seedrick/Open-ReVolt-AC/Hardware/AC Control BoM.xlsx

Sheet: ACControlAndDriverBoardBOM8-13-
Bill of Materials
Ref Name | Component | Value | Package | MPN
TEMP | 2 pin interface | 2pin vert lock | USER | 171856-0002 (http://www.mouser.com/ProductDetail/Molex/171856-0002/) | 171856-0002|6
 | 2 pin housing |  |  | 22-01-3027 (http://www.mouser.com/ProductDetail/Molex/22-01-3027/) | 22-01-3027|6
J4 | 2 pin interface | No Connector | bigHoles0-1LS
CONTACTOR | 2 pin interface | No Connector | bigHoles0-1LS
PRECHARGE | 2 pin interface | No Connector | bigHoles0-1LS
J2 | 2 pin interface | No Connector | bigHoles0-1LS
J3 | 2 pin interface | No Connector | bigHoles0-1LS
U20 | 7805Replacement |  | USER | OKI-78SR-5/1.5-W36-C (http://www.mouser.com/Search/ProductDetail.aspx) | OKI-78SR-5/1.5-W36-C (http://www.mouser.com/Search/ProductDetail.aspx)
U7 | ATTiny25 |  | DIP8 | ATTINY25-20PU (http://www.mouser.com/Search/ProductDetail.aspx) | ATTINY25-20PU (http://www.mouser.com/Search/ProductDetail.aspx)
D32 | BAT85,133 |  | USER | BAT85S-TAP (http://www.mouser.com/Search/ProductDetail.aspx)
D33 | BAT85,133 |  | USER | BAT85S-TAP (http://www.mouser.com/Search/ProductDetail.aspx)
C132 | Capacitor0.2-MLCC | 0.1uF | Cap01LS | K104K15X7RF53L2 (http://www.mouser.com/Search/ProductDetail.aspx)
C136 | Capacitor0.2-MLCC | 0.1uF | Cap01LS | K104K15X7RF53L2 (http://www.mouser.com/Search/ProductDetail.aspx)
C133 | Capacitor0.2-MLCC | 0.1uF | Cap01LS | K104K15X7RF53L2 (http://www.mouser.com/Search/ProductDetail.aspx)
C137 | Capacitor0.2-MLCC | 0.1uF | Cap01LS | K104K15X7RF53L2 (http://www.mouser.com/Search/ProductDetail.aspx)
C129 | Capacitor0.2-MLCC | 0.1uF | Cap01LS | K104K15X7RF53L2 (http://www.mouser.com/Search/ProductDetail.aspx)
C59 | Capacitor0.2-MLCC | 0.1uF | Cap01LS | K104K15X7RF53L2 (http://www.mouser.com/Search/ProductDetail.aspx)
C61 | Capacitor0.2-MLCC | 0.1uF | Cap01LS | K104K15X7RF53L2 (http://www.mouser.com/Search/ProductDetail.aspx)
C68 | Capacitor0.2-MLCC | 0.1uF | Cap01LS | K104K15X7RF53L2 (http://www.mouser.com/Search/ProductDetail.aspx)
C119 | Capacitor0.2-MLCC | 0.1uF | Cap01LS | K104K15X7RF53L2 (http://www.mouser.com/Search/ProductDetail.aspx)
C40 | Capacitor0.2-MLCC | 0.1uF | Cap01LS | K104K15X7RF53L2 (http://www.mouser.com/Search/ProductDetail.aspx)
C120 | Capacitor0.2-MLCC | 0.1uF | Cap01LS | K104K15X7RF53L2 (http://www.mouser.com/Search/ProductDetail.aspx)
C42 | Capacitor0.2-MLCC | 0.1uF | Cap01LS | K104K15X7RF53L2 (http://www.mouser.com/Search/ProductDetail.aspx)
C122 | Capacitor0.2-MLCC | 0.1uF | Cap01LS | K104K15X7RF53L2 (http://www.mouser.com/Search/ProductDetail.aspx)
C44 | Capacitor0.2-MLCC | 0.1uF | Cap01LS | K104K15X7RF53L2 (http://www.mouser.com/Search/ProductDetail.aspx)
C71 | Capacitor0.2-MLCC | 0.1uF | Cap01LS | K104K15X7RF53L2 (http://www.mouser.com/Search/ProductDetail.aspx)
C78 | Capacitor0.2-MLCC | 0.1uF | Cap01LS | K104K15X7RF53L2 (http://www.mouser.com/Search/ProductDetail.aspx)
C60 | Capacitor0.2-MLCC | 0.1uF | Cap01LS | K104K15X7RF53L2 (http://www.mouser.com/Search/ProductDetail.aspx)
C128 | Capacitor0.2-MLCC | 0.1uF | Cap01LS | K104K15X7RF53L2 (http://www.mouser.com/Search/ProductDetail.aspx)
C65 | Capacitor0.2-MLCC | 0.01uF | Cap01LS | K103K15X7RF5TL2 (http://www.mouser.com/Search/ProductDetail.aspx)
C64 | Capacitor0.2-MLCC | 0.01uF | Cap01LS | K103K15X7RF5TL2 (http://www.mouser.com/Search/ProductDetail.aspx)
C70 | Capacitor0.2-MLCC | 0.01uF | Cap01LS | K103K15X7RF5TL2 (http://www.mouser.com/Search/ProductDetail.aspx)
C69 | Capacitor0.2-MLCC | 0.01uF | Cap01LS | K103K15X7RF5TL2 (http://www.mouser.com/Search/ProductDetail.aspx)
C19 | Capacitor0.2-MLCC | 6800pF | Cap01LS | FK18X7R1H682K (http://www.mouser.com/Search/ProductDetail.aspx)
C99 | Capacitor0.2-MLCC | 6800pF | Cap01LS | FK18X7R1H682K (http://www.mouser.com/Search/ProductDetail.aspx)
C22 | Capacitor0.2-MLCC | 6800pF | Cap01LS | FK18X7R1H682K (http://www.mouser.com/Search/ProductDetail.aspx)
C102 | Capacitor0.2-MLCC | 6800pF | Cap01LS | FK18X7R1H682K (http://www.mouser.com/Search/ProductDetail.aspx)
C25 | Capacitor0.2-MLCC | 6800pF | Cap01LS | FK18X7R1H682K (http://www.mouser.com/Search/ProductDetail.aspx)
C105 | Capacitor0.2-MLCC | 6800pF | Cap01LS | FK18X7R1H682K (http://www.mouser.com/Search/ProductDetail.aspx)
C62 | Capacitor0.2-MLCC | 4.7uF | Cap01LS | FK14X7R1E475K (http://www.mouser.com/Search/ProductDetail.aspx)
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
U22 | GateDriveOptoWithReset | FOD8316 | SOIC16 | FOD8316 (http://www.mouser.com/ProductDetail/Fairchild-Semiconductor/FOD8316/?qs=sGAEpiMZZMvh4wEfREVcMVUAyWQG%252brzT)
U2 | GateDriveOptoWithReset | FOD8316 | SOIC16 | FOD8316 (http://www.mouser.com/ProductDetail/Fairchild-Semiconductor/FOD8316/?qs=sGAEpiMZZMvh4wEfREVcMVUAyWQG%252brzT)
U23 | GateDriveOptoWithReset | FOD8316 | SOIC16 | FOD8316 (http://www.mouser.com/ProductDetail/Fairchild-Semiconductor/FOD8316/?qs=sGAEpiMZZMvh4wEfREVcMVUAyWQG%252brzT)
U3 | GateDriveOptoWithReset | FOD8316 | SOIC16 | FOD8316 (http://www.mouser.com/ProductDetail/Fairchild-Semiconductor/FOD8316/?qs=sGAEpiMZZMvh4wEfREVcMVUAyWQG%252brzT)
U16 | HIN202CP |  | DIL | HIN202CPZ (http://www.mouser.com/Search/ProductDetail.aspx?R=HIN202CPZvirtualkey57760000virtualkey968-HIN202CPZ)
ISP | ISP-Interface |  | USER | 929834-02-06-RK (http://www.mouser.com/Search/ProductDetail.aspx)
U4 | IXDN604MosfetDriver |  | DIP8 | IXDN604PI (http://www.mouser.com/Search/ProductDetail.aspx?R=IXDN604PIvirtualkey56550000virtualkey849-IXDN604PI)
U24 | IXDN604MosfetDriver |  | DIP8 | IXDN604PI (http://www.mouser.com/Search/ProductDetail.aspx?R=IXDN604PIvirtualkey56550000virtualkey849-IXDN604PI)
U5 | IXDN604MosfetDriver |  | DIP8 | IXDN604PI (http://www.mouser.com/Search/ProductDetail.aspx?R=IXDN604PIvirtualkey56550000virtualkey849-IXDN604PI)
U25 | IXDN604MosfetDriver |  | DIP8 | IXDN604PI (http://www.mouser.com/Search/ProductDetail.aspx?R=IXDN604PIvirtualkey56550000virtualkey849-IXDN604PI)
U6 | IXDN604MosfetDriver |  | DIP8 | IXDN604PI (http://www.mouser.com/Search/ProductDetail.aspx?R=IXDN604PIvirtualkey56550000virtualkey849-IXDN604PI)
U26 | IXDN604MosfetDriver |  | DIP8 | IXDN604PI (http://www.mouser.com/Search/ProductDetail.aspx?R=IXDN604PIvirtualkey56550000virtualkey849-IXDN604PI)
CURRENT1 | LEMInterface | 3pin Vert Lock | writingFlipped | 22-23-2031 (http://www.mouser.com/Search/ProductDetail.aspx)
CURRENT3 | LEMInterface | 3pin Vert Lock | writingFlipped | 22-23-2031 (http://www.mouser.com/Search/ProductDetail.aspx)
CURRENT2 | LEMInterface | 3pin Vert Lock | writingFlipped | 22-23-2031 (http://www.mouser.com/Search/ProductDetail.aspx)
J1 | Hall Effect | 3pin Vert Lock |  | 22-23-2031 (http://www.mouser.com/Search/ProductDetail.aspx)
 | SerialInterface | 3pin Vert Lock |  | 22-23-2031 (http://www.mouser.com/Search/ProductDetail.aspx)
 |  | 3 pin Housing x 5 |  | 22-01-3037 (http://www.mouser.com/Search/ProductDetail.aspx)
 |  | 4 pin Housing x 3 |  | 22-01-3047 (http://www.mouser.com/Search/ProductDetail.aspx)
 |  | Crimp Pins x 34 |  | 08-50-0114 (http://www.mouser.com/Search/ProductDetail.aspx)
TRANS4 | Line Filter |  | 13x10mmHoles | PLA10AN3021R3R2B (http://www.mouser.com/Search/ProductDetail.aspx)
TRANS1 | Line Filter |  | 13x10mmHoles | PLA10AN3021R3R2B (http://www.mouser.com/Search/ProductDetail.aspx)
TRANS5 | Line Filter |  | 13x10mmHoles | PLA10AN3021R3R2B (http://www.mouser.com/Search/ProductDetail.aspx)
TRANS2 | Line Filter |  | 13x10mmHoles | PLA10AN3021R3R2B (http://www.mouser.com/Search/ProductDetail.aspx)
TRANS6 | Line Filter |  | 13x10mmHoles | PLA10AN3021R3R2B (http://www.mouser.com/Search/ProductDetail.aspx)
TRANS3 | Line Filter |  | 13x10mmHoles | PLA10AN3021R3R2B (http://www.mouser.com/Search/ProductDetail.aspx)
U8 | LM393 |  | DIP-8-Oval | LM293P (http://www.mouser.com/ProductDetail/Texas-Instruments/LM293P/)
U15 | LM393 |  | DIP-8-Oval | LM293P (http://www.mouser.com/ProductDetail/Texas-Instruments/LM293P/)
U9 | LM393 |  | DIP-8-Oval | LM293P (http://www.mouser.com/ProductDetail/Texas-Instruments/LM293P/)
U19 | LM393 |  | DIP-8-Oval | LM293P (http://www.mouser.com/ProductDetail/Texas-Instruments/LM293P/)
U12 | LM4040DIZ-2.5 | LM4040C25ILPR | TO92 | LM4040C25ILPR (http://www.mouser.com/Search/ProductDetail.aspx)
U18 | MC74HC00AD |  | dip14 | SN74HC00N (http://www.mouser.com/Search/ProductDetail.aspx?R=SN74HC00Nvirtualkey59500000virtualkey595-SN74HC00N)
Q7 | MOSFET n-ch |  | TO-92 | BS270 (http://www.mouser.com/Search/ProductDetail.aspx?R=BS270virtualkey51210000virtualkey512-BS270)
Q8 | MOSFET n-ch |  | TO-92 | BS270 (http://www.mouser.com/Search/ProductDetail.aspx?R=BS270virtualkey51210000virtualkey512-BS270)
Q9 | NPNTrans_D44VH10 |  | DPAK | 511-MJD44H11 (http://www.mouser.com/ProductDetail/STMicroelectronics/MJD44H11T4/)
Q2 | NPNTrans_D44VH10 |  | DPAK | 511-MJD44H11 (http://www.mouser.com/ProductDetail/STMicroelectronics/MJD44H11T4/)
Q11 | NPNTrans_D44VH10 |  | DPAK | 511-MJD44H11 (http://www.mouser.com/ProductDetail/STMicroelectronics/MJD44H11T4/)
Q13 | NPNTrans_D44VH10 |  | DPAK | 511-MJD44H11 (http://www.mouser.com/ProductDetail/STMicroelectronics/MJD44H11T4/)
Q6 | NPNTrans_D44VH10 |  | DPAK | 511-MJD44H11 (http://www.mouser.com/ProductDetail/STMicroelectronics/MJD44H11T4/)
Q4 | NPNTrans_D44VH10 |  | DPAK | 511-MJD44H11 (http://www.mouser.com/ProductDetail/STMicroelectronics/MJD44H11T4/)
D31 | P6KE20A-T | Bidirectional | USER | P6KE18CA (http://www.mouser.com/Search/ProductDetail.aspx?R=P6KE18CAvirtualkey51120000virtualkey511-P6KE18CA)
D30 | P6KE20A-T | Bidirectional | USER | P6KE18CA (http://www.mouser.com/Search/ProductDetail.aspx?R=P6KE18CAvirtualkey51120000virtualkey511-P6KE18CA)
Q1 | PNPTRANS_D45VH10 |  | DPAK | 863-MJD45H11T4G (http://www.mouser.com/Search/ProductDetail.aspx)
Q10 | PNPTRANS_D45VH10 |  | DPAK | 863-MJD45H11T4G (http://www.mouser.com/Search/ProductDetail.aspx)
Q3 | PNPTRANS_D45VH10 |  | DPAK | 863-MJD45H11T4G (http://www.mouser.com/Search/ProductDetail.aspx)
Q12 | PNPTRANS_D45VH10 |  | DPAK | 863-MJD45H11T4G (http://www.mouser.com/Search/ProductDetail.aspx)
Q5 | PNPTRANS_D45VH10 |  | DPAK | 863-MJD45H11T4G (http://www.mouser.com/Search/ProductDetail.aspx)
Q14 | PNPTRANS_D45VH10 |  | DPAK | 863-MJD45H11T4G (http://www.mouser.com/Search/ProductDetail.aspx)
QEI | QEI | 5p Vert 0.1ls | USER | 171856-1005 (http://www.mouser.com/Search/ProductDetail.aspx)
RELAY1 | Relay SPST 1FormA |  | User | ALQ305 (http://www.mouser.com/Search/ProductDetail.aspx?R=ALQ305virtualkey66710000virtualkey769-ALQ305)
RELAY2 | Relay SPST 1FormA |  | User | ALQ305 (http://www.mouser.com/Search/ProductDetail.aspx?R=ALQ305virtualkey66710000virtualkey769-ALQ305)
R22 | Resistor-0.25watt | 1k | R0_4 | MF1/4DCT52A1001F (http://www.mouser.com/Search/ProductDetail.aspx)
R39 | Resistor-0.25watt | 1k | R0_4 | MF1/4DCT52A1001F (http://www.mouser.com/Search/ProductDetail.aspx)
R50 | Resistor-0.25watt | 1k | R0_4 | MF1/4DCT52A1001F (http://www.mouser.com/Search/ProductDetail.aspx)
R52 | Resistor-0.25watt | 1k | R0_4 | MF1/4DCT52A1001F (http://www.mouser.com/Search/ProductDetail.aspx)
R54 | Resistor-0.25watt | 1k | R0_4 | MF1/4DCT52A1001F (http://www.mouser.com/Search/ProductDetail.aspx)
R55 | Resistor-0.25watt | 1k | R0_4 | MF1/4DCT52A1001F (http://www.mouser.com/Search/ProductDetail.aspx)
R56 | Resistor-0.25watt | 1k | R0_4 | MF1/4DCT52A1001F (http://www.mouser.com/Search/ProductDetail.aspx)
R60 | Resistor-0.25watt | 1k | RVertical | MF1/4DCT52A1001F (http://www.mouser.com/Search/ProductDetail.aspx)
R63 | Resistor-0.25watt | 1k | R0_4 | MF1/4DCT52A1001F (http://www.mouser.com/Search/ProductDetail.aspx)
R64 | Resistor-0.25watt | 1k | R0_4 | MF1/4DCT52A1001F (http://www.mouser.com/Search/ProductDetail.aspx)
R31 | Resistor-0.25watt | 1.5k | R0_4 | CCF601K50FKE36 (http://www.mouser.com/ProductDetail/Vishay-Dale/CCF601K50FKE36/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)
R25 | Resistor-0.25watt | 2k | R0_4 | MF1/4DCT52A2001F (http://www.mouser.com/Search/ProductDetail.aspx)
R26 | Resistor-0.25watt | 2k | R0_4 | MF1/4DCT52A2001F (http://www.mouser.com/Search/ProductDetail.aspx)
R48 | Resistor-0.25watt | 2k | R0_4 | MF1/4DCT52A2001F (http://www.mouser.com/Search/ProductDetail.aspx)
R49 | Resistor-0.25watt | 2k | R0_4 | MF1/4DCT52A2001F (http://www.mouser.com/Search/ProductDetail.aspx)
R27 | Resistor-0.25watt | 2k | R0_4 | MF1/4DCT52A2001F (http://www.mouser.com/Search/ProductDetail.aspx)
R29 | Resistor-0.25watt | 2k | R0_4 | MF1/4DCT52A2001F (http://www.mouser.com/Search/ProductDetail.aspx)
R58 | Resistor-0.25watt | 2k | R0_4 | MF1/4DCT52A2001F (http://www.mouser.com/Search/ProductDetail.aspx)
R59 | Resistor-0.25watt | 2k | R0_4 | MF1/4DCT52A2001F (http://www.mouser.com/Search/ProductDetail.aspx)
R51 | Resistor-0.25watt | 100k | R0_4 | MFR-25FRF52-100K (http://www.mouser.com/Search/ProductDetail.aspx)
R33 | Resistor-0.25watt | 1k | R0_4 | MF1/4DCT52A1001F (http://www.mouser.com/Search/ProductDetail.aspx)
R46 | Resistor-0.25watt | 2.8k 0.1% | R0_4 | CMF1/42801FLFTR (http://www.mouser.com/Search/ProductDetail.aspx)
R19 | Resistor-0.25watt | 2.7Ohm | r0-500 | OF27GJE (http://www.mouser.com/Search/ProductDetail.aspx?R=OF27GJEvirtualkey58810000virtualkey588-OF27GJE)
R84 | Resistor-0.25watt | 2.7Ohm | r0-500 | OF27GJE (http://www.mouser.com/Search/ProductDetail.aspx?R=OF27GJEvirtualkey58810000virtualkey588-OF27GJE)
R20 | Resistor-0.25watt | 2.7Ohm | r0-500 | OF27GJE (http://www.mouser.com/Search/ProductDetail.aspx?R=OF27GJEvirtualkey58810000virtualkey588-OF27GJE)
R85 | Resistor-0.25watt | 2.7Ohm | r0-500 | OF27GJE (http://www.mouser.com/Search/ProductDetail.aspx?R=OF27GJEvirtualkey58810000virtualkey588-OF27GJE)
R21 | Resistor-0.25watt | 2.7Ohm | r0-500 | OF27GJE (http://www.mouser.com/Search/ProductDetail.aspx?R=OF27GJEvirtualkey58810000virtualkey588-OF27GJE)
R86 | Resistor-0.25watt | 2.7Ohm | r0-500 | OF27GJE (http://www.mouser.com/Search/ProductDetail.aspx?R=OF27GJEvirtualkey58810000virtualkey588-OF27GJE)
R24 | Resistor-0.25watt | 3k | R0_4 | MF1/4DC3001F (http://www.mouser.com/ProductDetail/KOA-Speer/MF1-4DC3001F/)
R62 | Resistor-0.25watt | 3k | R0_4 | MF1/4DC3001F
R65 | Resistor-0.25watt | 3k | R0_4 | MF1/4DC3001F
R32 | Resistor-0.25watt | 3k | R0_4 | MF1/4DC3001F
R75 | Resistor-0.25watt | 3k | 1210 | CRCW12103K00JNEA (http://www.mouser.com/Search/ProductDetail.aspx)
R10 | Resistor-0.25watt | 3k | 1210 | CRCW12103K00JNEA (http://www.mouser.com/Search/ProductDetail.aspx)
R76 | Resistor-0.25watt | 3k | 1210 | CRCW12103K00JNEA (http://www.mouser.com/Search/ProductDetail.aspx)
R11 | Resistor-0.25watt | 3k | 1210 | CRCW12103K00JNEA (http://www.mouser.com/Search/ProductDetail.aspx)
R77 | Resistor-0.25watt | 3k | 1210 | CRCW12103K00JNEA (http://www.mouser.com/Search/ProductDetail.aspx)
R12 | Resistor-0.25watt | 3k | 1210 | CRCW12103K00JNEA (http://www.mouser.com/Search/ProductDetail.aspx)
R2 | Resistor-0.25watt | 3.3Ohm 1w | R0800 | OX33GKE (http://www.mouser.com/Search/ProductDetail.aspx?R=OX33GKEvirtualkey58810000virtualkey588-OX-3.3-E)
R66 | Resistor-0.25watt | 3.3Ohm 1w | R0800 | OX33GKE (http://www.mouser.com/Search/ProductDetail.aspx?R=OX33GKEvirtualkey58810000virtualkey588-OX-3.3-E)
R67 | Resistor-0.25watt | 3.3Ohm 1w | R0800 | OX33GKE (http://www.mouser.com/Search/ProductDetail.aspx?R=OX33GKEvirtualkey58810000virtualkey588-OX-3.3-E)
R3 | Resistor-0.25watt | 3.3Ohm 1w | R0800 | OX33GKE (http://www.mouser.com/Search/ProductDetail.aspx?R=OX33GKEvirtualkey58810000virtualkey588-OX-3.3-E)
R4 | Resistor-0.25watt | 3.3Ohm 1w | R0800 | OX33GKE (http://www.mouser.com/Search/ProductDetail.aspx?R=OX33GKEvirtualkey58810000virtualkey588-OX-3.3-E)
R68 | Resistor-0.25watt | 3.3Ohm 1w | R0800 | OX33GKE (http://www.mouser.com/Search/ProductDetail.aspx?R=OX33GKEvirtualkey58810000virtualkey588-OX-3.3-E)
R69 | Resistor-0.25watt | 3.3Ohm 1w | R0800 | OX33GKE (http://www.mouser.com/Search/ProductDetail.aspx?R=OX33GKEvirtualkey58810000virtualkey588-OX-3.3-E)
R5 | Resistor-0.25watt | 3.3Ohm 1w | R0800 | OX33GKE (http://www.mouser.com/Search/ProductDetail.aspx?R=OX33GKEvirtualkey58810000virtualkey588-OX-3.3-E)
R6 | Resistor-0.25watt | 3.3Ohm 1w | R0800 | OX33GKE (http://www.mouser.com/Search/ProductDetail.aspx?R=OX33GKEvirtualkey58810000virtualkey588-OX-3.3-E)
R70 | Resistor-0.25watt | 3.3Ohm 1w | R0800 | OX33GKE (http://www.mouser.com/Search/ProductDetail.aspx?R=OX33GKEvirtualkey58810000virtualkey588-OX-3.3-E)
R71 | Resistor-0.25watt | 3.3Ohm 1w | R0800 | OX33GKE (http://www.mouser.com/Search/ProductDetail.aspx?R=OX33GKEvirtualkey58810000virtualkey588-OX-3.3-E)
R7 | Resistor-0.25watt | 3.3Ohm 1w | R0800 | OX33GKE (http://www.mouser.com/Search/ProductDetail.aspx?R=OX33GKEvirtualkey58810000virtualkey588-OX-3.3-E)
R43 | Resistor-0.25watt | 3.92k 0.1% | R0_4 | MF1/4DC3921F (http://www.mouser.com/Search/ProductDetail.aspx)
R40 | Resistor-0.25watt | 4.7k | R0_4 | MF1/4DCT52R4701F (http://www.mouser.com/Search/ProductDetail.aspx)
R44 | Resistor-0.25watt | 4.7k 0.1% | R0_4 | MF1/4DCT52R4701F (http://www.mouser.com/Search/ProductDetail.aspx)
R61 | Resistor-0.25watt | 4.7k | RVertical | MF1/4DCT52R4701F (http://www.mouser.com/Search/ProductDetail.aspx)
R13 | Resistor-0.25watt | 15Ohm 0.5w | 45 | 273-15-RC (http://www.mouser.com/Search/ProductDetail.aspx?R=273-15-RCvirtualkey21980000virtualkey273-15-RC)
R78 | Resistor-0.25watt | 15Ohm 0.5w | 45 | 273-15-RC (http://www.mouser.com/Search/ProductDetail.aspx?R=273-15-RCvirtualkey21980000virtualkey273-15-RC)
R14 | Resistor-0.25watt | 15Ohm 0.5w | 45 | 273-15-RC (http://www.mouser.com/Search/ProductDetail.aspx?R=273-15-RCvirtualkey21980000virtualkey273-15-RC)
R79 | Resistor-0.25watt | 15Ohm 0.5w | 45 | 273-15-RC (http://www.mouser.com/Search/ProductDetail.aspx?R=273-15-RCvirtualkey21980000virtualkey273-15-RC)
R15 | Resistor-0.25watt | 15Ohm 0.5w | 45 | 273-15-RC (http://www.mouser.com/Search/ProductDetail.aspx?R=273-15-RCvirtualkey21980000virtualkey273-15-RC)
R80 | Resistor-0.25watt | 15Ohm 0.5w | 45 | 273-15-RC (http://www.mouser.com/Search/ProductDetail.aspx?R=273-15-RCvirtualkey21980000virtualkey273-15-RC)
R45 | Resistor-0.25watt | 10k | R0_4 | MF1/4DC1002F (http://www.mouser.com/Search/ProductDetail.aspx)
R23 | Resistor-0.25watt | 10k | R0_4 | MF1/4DC1002F (http://www.mouser.com/Search/ProductDetail.aspx)
R28 | Resistor-0.25watt | 10k | R0_4 | MF1/4DC1002F (http://www.mouser.com/Search/ProductDetail.aspx)
R30 | Resistor-0.25watt | 10k | R0_4 | MF1/4DC1002F (http://www.mouser.com/Search/ProductDetail.aspx)
R42 | Resistor-0.25watt | 10k | RVertical | MF1/4DC1002F (http://www.mouser.com/Search/ProductDetail.aspx)
R36 | Resistor-0.25watt | 10k | R0_4 | MF1/4DC1002F (http://www.mouser.com/Search/ProductDetail.aspx)
R37 | Resistor-0.25watt | 10k | R0_4 | MF1/4DC1002F (http://www.mouser.com/Search/ProductDetail.aspx)
R35 | Resistor-0.25watt | 10k | R0_4 | MF1/4DC1002F (http://www.mouser.com/Search/ProductDetail.aspx)
R38 | Resistor-0.25watt | 10k | R0_4 | MF1/4DC1002F (http://www.mouser.com/Search/ProductDetail.aspx)
R41 | Resistor-0.25watt | 10k | R0_4 | MF1/4DC1002F (http://www.mouser.com/Search/ProductDetail.aspx)
R34 | Resistor-0.25watt | 10k | R0_4 | MF1/4DC1002F (http://www.mouser.com/Search/ProductDetail.aspx)
R47 | Resistor-0.25watt | 22k 0.1% | R0_4 | MF1/4DC2202F (http://www.mouser.com/Search/ProductDetail.aspx)
R16 | Resistor-0.25watt | 47k | 1210 | CRCW121047K0JNEA (http://www.mouser.com/Search/ProductDetail.aspx)
R81 | Resistor-0.25watt | 47k | 1210 | CRCW121047K0JNEA (http://www.mouser.com/Search/ProductDetail.aspx)
R17 | Resistor-0.25watt | 47k | 1210 | CRCW121047K0JNEA (http://www.mouser.com/Search/ProductDetail.aspx)
R82 | Resistor-0.25watt | 47k | 1210 | CRCW121047K0JNEA (http://www.mouser.com/Search/ProductDetail.aspx)
R18 | Resistor-0.25watt | 47k | 1210 | CRCW121047K0JNEA (http://www.mouser.com/Search/ProductDetail.aspx)
R83 | Resistor-0.25watt | 47k | 1210 | CRCW121047K0JNEA (http://www.mouser.com/Search/ProductDetail.aspx)
R1 | Resistor-0.25watt | 100 | 1210 | RK73B2ETTE101J (http://www.mouser.com/Search/ProductDetail.aspx)
R73 | Resistor-0.25watt | 100 | 1210 | RK73B2ETTE101J (http://www.mouser.com/Search/ProductDetail.aspx)
R8 | Resistor-0.25watt | 100 | 1210 | RK73B2ETTE101J (http://www.mouser.com/Search/ProductDetail.aspx)
R74 | Resistor-0.25watt | 100 | 1210 | RK73B2ETTE101J (http://www.mouser.com/Search/ProductDetail.aspx)
R9 | Resistor-0.25watt | 100 | 1210 | RK73B2ETTE101J (http://www.mouser.com/Search/ProductDetail.aspx)
R72 | Resistor-0.25watt | 100 | 1210 | RK73B2ETTE101J (http://www.mouser.com/Search/ProductDetail.aspx)
R57 | Resistor-0.25watt | 470 | R0_4 | MF1/4DC4700F (http://www.mouser.com/Search/ProductDetail.aspx)
R53 | Resistor-0.25watt | xxx | R0_4
U11 | SN74HC08 |  | dip14 | SN74HC08N (http://www.mouser.com/Search/ProductDetail.aspx?R=SN74HC08Nvirtualkey59500000virtualkey595-SN74HC08N)
U14 | SN74HC08 |  | dip14 | SN74HC08N (http://www.mouser.com/Search/ProductDetail.aspx?R=SN74HC08Nvirtualkey59500000virtualkey595-SN74HC08N)
U10 | SN74HC21 |  | dip14 | SN74HC21N (http://www.mouser.com/Search/ProductDetail.aspx?R=SN74HC21Nvirtualkey59500000virtualkey595-SN74HC21N)
U17 | SN74HC21 |  | dip14 | SN74HC21N (http://www.mouser.com/Search/ProductDetail.aspx?R=SN74HC21Nvirtualkey59500000virtualkey595-SN74HC21N)
D29 | STTH2R02 | 1n4148 | vertical | 1N4148-B (http://www.mouser.com/Search/ProductDetail.aspx?R=1N4148-Bvirtualkey58300000virtualkey583-1N4148-B)
D28 | STTH2R02 | 1n4148 | vertical | 1N4148-B (http://www.mouser.com/Search/ProductDetail.aspx?R=1N4148-Bvirtualkey58300000virtualkey583-1N4148-B)
D35 | STTH2R02 | 1000V Ultrafast | 0_45Inch | UF4007-E3/54
D7 | STTH2R02 | 1000V Ultrafast | 0_45Inch | UF4007-E3/54
D36 | STTH2R02 | 1000V Ultrafast | 0_45Inch | UF4007-E3/54
D8 | STTH2R02 | 1000V Ultrafast | 0_45Inch | UF4007-E3/54
D37 | STTH2R02 | 1000V Ultrafast | 0_45Inch | UF4007-E3/54
D9 | STTH2R02 | 1000V Ultrafast | 0_45Inch | UF4007-E3/54
D34 | ZenerDiode | 5.1v Zener | Diode_small | BZX55B5V1-TAP
D23 | ZenerDiode | 8.2v 5w | 5wVertical | 1N5344B-TP (http://www.mouser.com/Search/ProductDetail.aspx)
D50 | ZenerDiode | 8.2v 5w | 5wVertical | 1N5344B-TP (http://www.mouser.com/Search/ProductDetail.aspx)
D25 | ZenerDiode | 8.2v 5w | 5wVertical | 1N5344B-TP (http://www.mouser.com/Search/ProductDetail.aspx)
D52 | ZenerDiode | 8.2v 5w | 5wVertical | 1N5344B-TP (http://www.mouser.com/Search/ProductDetail.aspx)
D27 | ZenerDiode | 8.2v 5w | 5wVertical | 1N5344B-TP (http://www.mouser.com/Search/ProductDetail.aspx)
D54 | ZenerDiode | 8.2v 5w | 5wVertical | 1N5344B-TP (http://www.mouser.com/Search/ProductDetail.aspx)
D1 | ZenerDiode | 17v 5w x2 | bidirectVert | 1N5354BG
D2 | ZenerDiode | 17v 5w x2 | bidirectVert | 1N5354BG
D3 | ZenerDiode | 17v 5w x2 | bidirectVert | 1N5354BG
D6 | ZenerDiode | 17v 5w x2 | bidirectVert | 1N5354BG
D5 | ZenerDiode | 17v 5w x2 | bidirectVert | 1N5354BG
D4 | ZenerDiode | 17v 5w x2 | bidirectVert | 1N5354BG
D22 | ZenerDiode | 24v Zener | 5wVertical | 1N5359BG
D51 | ZenerDiode | 24v Zener | 5wVertical | 1N5359BG
D24 | ZenerDiode | 24v Zener | 5wVertical | 1N5359BG
D53 | ZenerDiode | 24v Zener | 5wVertical | 1N5359BG
D26 | ZenerDiode | 24v Zener | 5wVertical | 1N5359BG
D55 | ZenerDiode | 24v Zener | 5wVertical | 1N5359BG
Thermistor |  |  |  | NTCALUG03A103G (http://www.mouser.com/Search/ProductDetail.aspx)
 |  |  |  | Total Cost

Sheet: Sheet1
 |  |  |  |  |  | 0.888
0.00013366533 |  |  |  |  |  | 2.8125
 |  |  |  |  |  |  |  |  |  | 0.125 | 0.03978873577
 |  |  |  |  | 17.53624817 |  |  |  |  |  | 0.1994711402 |  | 0.00000001
 |  |  | 12.4 |  | 0.1140494808 | 0.1140433553 |  |  | 0.04659393939
 |  |  | 0.1612903226 | 6.2
 |  |  | 352 |  | 1.990123457
 |  |  | 0.169
 | 2.7 | 0.1093117409 | 22.87037037 |  |  |  |  | 274.1633199 |  |  |  |  | 32624 | 0 | 32624
 | 2.75 | 0.1111111111 | 22.5 |  |  |  |  | 829.1497976 |  |  |  | -1448.6 | 31175.4 | 1 | 31175
 | 2.8 | 0.1129032258 | 22.14285714 |  |  |  |  | 412.0724346 |  |  |  | -1448.6 | 29726.8 | 2 | 29727
 |  | 0 | #DIV/0! |  |  |  |  |  |  |  |  | -1448.6 | 28278.2 | 3 | 28278
 |  | 0 | #DIV/0! |  |  |  |  |  |  |  |  | -1448.6 | 26829.6 | 4 | 26830
 |  | 0 | #DIV/0! |  |  |  |  |  |  |  |  | -1448.6 | 25381 | 5 | 25381
 |  | 0 | #DIV/0! |  |  |  |  |  |  |  |  | -1096.8 | 24284.2 | 6 | 24284
 |  | 0 | #DIV/0! |  |  |  |  |  |  |  |  | -1096.8 | 23187.4 | 7 | 23187
 |  | 0 | #DIV/0! |  |  |  |  |  |  |  |  | -1096.8 | 22090.6 | 8 | 22091
 |  | 0 | #DIV/0! |  |  |  |  |  |  |  |  | -1096.8 | 20993.8 | 9 | 20994
 |  | 0 | #DIV/0! |  |  |  |  |  | 8000 | -837.2 |  | -1096.8 | 19897 | 10 | 19897
 |  | 0 | #DIV/0! |  |  |  |  |  | 3750 | -643.6 |  | -837.2 | 19059.8 | 11 | 19060
 |  | 0 | #DIV/0! |  |  |  |  |  | 1875 | -498.6 |  | -837.2 | 18222.6 | 12 | 18223
 |  | 0 | #DIV/0! |  |  |  |  |  |  |  |  | -837.2 | 17385.4 | 13 | 17385
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
 |  |  |  |  |  |  | -11.9328 |  |  |  |  | -11.156 | 406.722 | 118 | 407
 |  |  |  |  |  |  | -11.5444 |  |  |  |  | -11.156 | 395.566 | 119 | 396
 |  |  |  |  |  |  | -11.156 |  |  |  |  | -11.156 | 384.41 | 120 | 384
 |  |  |  |  |  |  | -10.8312 |  |  |  |  | -9.532 | 374.878 | 121 | 375
 |  |  |  |  |  |  | -10.5064 |  |  |  |  | -9.532 | 365.346 | 122 | 365
 |  |  |  |  |  |  | -10.1816 |  |  |  |  | -9.532 | 355.814 | 123 | 356
 |  |  |  |  |  |  | -9.8568 |  |  |  |  | -9.532 | 346.282 | 124 | 346
 |  |  |  |  |  |  | -9.532 |  |  |  |  | -9.532 | 336.75 | 125 | 337
 |  |  |  |  |  |  |  |  |  |  |  | -9.532 | 327.218 | 126 | 327
