seedrick/Open-ReVolt-AC/(list of files, drawings)

Other design files:
Hardware/ACControlAndDriverBoard1.pcb
