seedrick/Open-ReVolt-AC/Software/PIC30F4011/OpenRevolt-AC.X/ACController.c

#include "ACController.h"

/*****************Config bit settings****************/
_FOSC(0xFFFF & XT_PLL16);//XT_PLL4); // Use XT with external crystal from 4MHz to 10MHz.  FRM Pg. 178
// nominal clock is 128kHz.  The counter is 1 byte. 
//#define STANDARD_THROTTLE
//#ifdef DEBUG
	_FWDT(WDT_OFF);
//#else
//	_FWDT(WDT_ON & WDTPSA_64 & WDTPSB_8); // See Pg. 709 in F.R.M.  Timeout in 1 second or so.  128000 / 64 / 8 / 256
//#endif

_FBORPOR(0xFFFF & BORV_27 & PWRT_64 & MCLR_EN & PWMxL_ACT_HI & PWMxH_ACT_HI); // Brown Out voltage set to 2v.  Power up time of 64 ms. MCLR is enabled.
// PWMxL_ACT_HI means PDC1 = 0 would mean PWM1L is 0 volts.  Just the opposite of how I always thought it worked.  haha.
// PWMxH_ACT_HI means, in complementary mode, that PDC1 = 0 would mean PWM1H is 0v, and PWM1L is 5v. 
_FGS(CODE_PROT_OFF);

//25,400,624,972,5
#ifndef PAULS_MOTOR
const SavedValuesStruct savedValuesDefault = {
	AC_INDUCTION_MOTOR,DEFAULT_KP,DEFAULT_KI,DEFAULT_CURRENT_SENSOR_AMPS_PER_VOLT,390,490,510,610,5,MAX_BATTERY_AMPS,MAX_BATTERY_AMPS_REGEN,MAX_MOTOR_AMPS,MAX_MOTOR_AMPS,DEFAULT_PRECHARGE_TIME,{0},0
};

volatile SavedValuesStruct savedValues = {
	AC_INDUCTION_MOTOR,DEFAULT_KP,DEFAULT_KI,DEFAULT_CURRENT_SENSOR_AMPS_PER_VOLT,390,490,510,610,5,MAX_BATTERY_AMPS,MAX_BATTERY_AMPS_REGEN,MAX_MOTOR_AMPS,MAX_MOTOR_AMPS,DEFAULT_PRECHARGE_TIME,{0},0
};

const SavedValuesStruct2 savedValuesDefault2 = {
	0, DEFAULT_ROTOR_TIME_CONSTANT_INDEX,DEFAULT_NUM_POLE_PAIRS,DEFAULT_MAX_MECHANICAL_RPM,DEFAULT_THROTTLE_TYPE, DEFAULT_ENCODER_TICKS,DEFAULT_DATA_TO_DISPLAY_SET1, DEFAULT_DATA_TO_DISPLAY_SET2,0,{0,0,0,0,0,0}, 0
};
volatile SavedValuesStruct2 savedValues2 = {
	0, DEFAULT_ROTOR_TIME_CONSTANT_INDEX,DEFAULT_NUM_POLE_PAIRS,DEFAULT_MAX_MECHANICAL_RPM,DEFAULT_THROTTLE_TYPE, DEFAULT_ENCODER_TICKS,DEFAULT_DATA_TO_DISPLAY_SET1, DEFAULT_DATA_TO_DISPLAY_SET2,0,{0,0,0,0,0,0}, 0
};
#else
const SavedValuesStruct savedValuesDefault = {
//	DEFAULT_MOTOR_TYPE,DEFAULT_KP,DEFAULT_KI,DEFAULT_CURRENT_SENSOR_AMPS_PER_VOLT,25,400,624,972,5,MAX_BATTERY_AMPS,MAX_BATTERY_AMPS_REGEN,MAX_MOTOR_AMPS,MAX_MOTOR_AMPS,DEFAULT_PRECHARGE_TIME,{0},0
	DEFAULT_MOTOR_TYPE,DEFAULT_KP,DEFAULT_KI,DEFAULT_CURRENT_SENSOR_AMPS_PER_VOLT,4,5,200,900,3,MAX_BATTERY_AMPS,MAX_BATTERY_AMPS_REGEN,MAX_MOTOR_AMPS,MAX_MOTOR_AMPS,DEFAULT_PRECHARGE_TIME,{0},0
};

volatile SavedValuesStruct savedValues = {
//	DEFAULT_MOTOR_TYPE,DEFAULT_KP,DEFAULT_KI,DEFAULT_CURRENT_SENSOR_AMPS_PER_VOLT,25,400,624,972,5,MAX_BATTERY_AMPS,MAX_BATTERY_AMPS_REGEN,MAX_MOTOR_AMPS,MAX_MOTOR_AMPS,DEFAULT_PRECHARGE_TIME,{0},0
	DEFAULT_MOTOR_TYPE,DEFAULT_KP,DEFAULT_KI,DEFAULT_CURRENT_SENSOR_AMPS_PER_VOLT,4,5,200,900,3,MAX_BATTERY_AMPS,MAX_BATTERY_AMPS_REGEN,MAX_MOTOR_AMPS,MAX_MOTOR_AMPS,DEFAULT_PRECHARGE_TIME,{0},0
};

const SavedValuesStruct2 savedValuesDefault2 = {
	DEFAULT_ANGLE_OFFSET, DEFAULT_ROTOR_TIME_CONSTANT_INDEX,DEFAULT_NUM_POLE_PAIRS,DEFAULT_MAX_MECHANICAL_RPM,DEFAULT_THROTTLE_TYPE, DEFAULT_ENCODER_TICKS,DEFAULT_DATA_TO_DISPLAY_SET1, DEFAULT_DATA_TO_DISPLAY_SET2,0,{0,0,0,0,0,0}, 0
};
volatile SavedValuesStruct2 savedValues2 = {
	DEFAULT_ANGLE_OFFSET, DEFAULT_ROTOR_TIME_CONSTANT_INDEX,DEFAULT_NUM_POLE_PAIRS,DEFAULT_MAX_MECHANICAL_RPM,DEFAULT_THROTTLE_TYPE, DEFAULT_ENCODER_TICKS,DEFAULT_DATA_TO_DISPLAY_SET1, DEFAULT_DATA_TO_DISPLAY_SET2,0,{0,0,0,0,0,0}, 0
};
#endif

// this is for computing the mechanicalRPM of an induction motor.  You let the 10kHz ISR run for revCounterMax number of times, and then measure the encoder position.  Whatever the encoder position is, is the 16 times the mechanical revolutions per second! 
// It has to be initialized though, so here we are, initializing it...
unsigned int revCounterMax = 160000L/(4*DEFAULT_ENCODER_TICKS);  // revCounterMax = 160000L / (4*savedValues2.encoderTicks);  // 4* because I'm doing 4 times resolution for the encoder. 16,000,000 because revolutions per 16 seconds is computed as:  16*10,000*poscnt * rev/(maxPosCnt*revcounter*(16sec))

// This is always a copy of the data that's in the EE PROM.
// To change EE Prom, modify this, and then copy it to EE Prom.

int EEDataInRam1[] = {0,0,0,0,0,0,0,0,0,0,0,0,0,0,0,0};
int EEDataInRam2[] = {0,0,0,0,0,0,0,0,0,0,0,0,0,0,0,0};
int EEDataInRam3[] = {0,0,0,0,0,0,0,0,0,0,0,0,0,0,0,0};
int EEDataInRam4[] = {0,0,0,0,0,0,0,0,0,0,0,0,0,0,0,0};

_prog_addressT EE_addr1 = 0x7ffc00;
_prog_addressT EE_addr2 = 0x7ffc20;
_prog_addressT EE_addr3 = 0x7ffc40;
_prog_addressT EE_addr4 = 0x7ffc60;

// celciusToResistance[0] is the resistance in Ohms that corresponds to 0 degrees celcius.  celciusToResistance[59] is the resistance in Ohms that corresponds to 59 degrees celcius.
// the range is 0 celcius to 126 degrees celcius.
// degrees celcius: 				0, 		1,	2,		3,	4,		5,	6,		7,	8,		9,	10,		11,	12,		13,	14,		15,	16,		17,	18,		19,	20,		21,	22,		23,	24,		25,	26,	27,	  28,	29, 30,  31,   32,  33,  34,  35,  36,  37,  38,  39,  40,  41,  42,  43,  44,  45,  46,  47,  48,  49,  50,  51,  52,  53,  54,  55,  56,  57,  58,  59,  60,  61,  62,  63,  64,  65,  66,  67,  68,  69,  70,  71,  72,  73,  74,  75,  76,  77,  78,  79,  80,  81,  82,  83,  84,  85,  86,  87, 88, 89, 90, 91, 92, 93, 94, 95, 96, 97, 98, 99,100,101,102,103,104,105,106,107,108,109,110,111,112,113,114,115,116,117,118,119,120,121,122,123,124,125,126,
const int celciusToResistance[] = {32624,31175,29727,28278,26830,25381,24284,23187,22091,20994,19897,19060,18223,17385,16548,15711,15067,14424,13780,13137,12493,11994,11496,10997,10499,10000,9611,9222,8834,8445,8056,7751,7445,7140,6835,6530,6289,6047,5806,5565,5324,5132,4940,4749,4557,4365,4212,4059,3905,3752,3599,3475,3352,3229,3106,2982,2883,2783,2683,2584,2484,2403,2322,2241,2160,2079,2013,1946,1880,1814,1748,1693,1639,1585,1530,1476,1431,1386,1341,1297,1252,1215,1178,1140,1103,1066,1035,1004,973,942,912,886,860,834,808,782,761,739,717,696,674,656,638,619,601,583,567,552,537,521,506,493,479,466,453,440,429,418,407,396,384,375,365,356,346,337,327,
};

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
};

// Ex:  If you have a right triangle, given hypotenuse C and leg A, this gives you the unknown leg B.  C is normalized to 1024.  Leg A is in [0, 1023].  The unknown Leg B is also in [0, 1023].  Leg B = sqrt(C^2 - A^2).
// This is used in the correction for an interior permanent magnet motor.  Throttle command ("current radius") is the hypotenuse.  Given a normalized "current radius" in [0, 1023], let's see what <IdRefRef,IqRefRef> gives the best acceleration.  That would be best torque I guess for a given currentRadius = sqrt(Id^2 + Iq^2).
// That would let you solve for K:
// From that TI video (teaching old motors new tricks part 4), after simplifying some, you get Id = -K + sqrt(K*K - currentRadius*currentRadius/2).  This is of the form of the quadratic formula.  x = (-b +/- sqrt(b^2 -4ac))/(2a), where ax*x + bx + c = 0.  So, from that, comparing terms, we find that b = K, c = currentRadius*currentRadius/4, a = 1/2, and x = Id.  So, we have
// 1/2*Id*Id + K*Id + currentRadius*currentRadius/4 = 0		// ax*x + bx + c = 0
// Now, solve for K:
// K = (currentRadius*currentRadius + 2*Id*Id)/(-4*Id).  Write it that way so as to not lose resolution by dividing too early.  We want a big numerator before dividing.
// I think K = 0.25*lambdaMagnets/(Ld - Lq).  I don't have a friggen clue what the values Ld, Lq, or lambdaMagnets are.  But who cares?  Then, you can use the following formulas to compute IdRef and IqRef, given the "current radius":
// IdRefRef = -K + sqrt(K*K - (currentRadius*currentRadius/sqrt(2))^2). **ALWAYS NEGATIVE**
// IqRefRef = sign()*sqrt(currentRadius^2 - IdRefRef^2).  It is negative if you are wanting to do regen, and is positive otherwise.
// Then, if <Vd,Vq> has too large of a radius to successfully command the feedback currents to IqRefRef and IdRefRef, you scale down Vd & Vq & IqRef & IdRef so that radius(Vd,Vq) is once again safely inside the available voltage disk.  This is the "field weakening" of sorts.
// Then, you let IqRef and IdRef ramp back to IqRefRef and IdRefRef.  Like teenagers.  You knock them back away from the boundary, and they start creeping up again.
// 
// Entries 0 thorugh 1023 inclusive.
const int unknownTriangleLegLookup[] = {
1024,1024,1024,1024,1024,1024,1024,1024,1024,1024,1024,1024,1024,1024,1024,1024,1024,1024,1024,1024,1024,1024,1024,1024,1024,1024,1024,1024,1024,1024,1024,1024,1023,1023,1023,1023,1023,1023,1023,1023,1023,1023,1023,1023,1023,1023,1023,1023,1023,1023,1023,1023,1023,1023,1023,1023,1022,1022,1022,1022,1022,1022,1022,1022,1022,1022,1022,1022,1022,1022,1022,1022,1021,1021,1021,1021,1021,1021,1021,1021,1021,1021,1021,1021,1021,1020,1020,1020,1020,1020,1020,1020,1020,1020,1020,1020,1019,1019,1019,1019,1019,1019,1019,1019,1019,1019,1018,1018,1018,1018,1018,1018,1018,1018,1018,1018,1017,1017,1017,1017,1017,1017,1017,1017,1016,1016,1016,1016,1016,1016,1016,1016,1015,1015,1015,1015,1015,1015,1015,1015,1014,1014,1014,1014,1014,1014,1014,1013,1013,
1013,1013,1013,1013,1013,1012,1012,1012,1012,1012,1012,1011,1011,1011,1011,1011,1011,1010,1010,1010,1010,1010,1010,1009,1009,1009,1009,1009,1009,1008,1008,1008,1008,1008,1008,1007,1007,1007,1007,1007,1006,1006,1006,1006,1006,1005,1005,1005,1005,1005,1004,1004,1004,1004,1004,1003,1003,1003,1003,1003,1002,1002,1002,1002,1002,1001,1001,1001,1001,1001,1000,1000,1000,1000,999,999,999,999,999,998,998,998,998,997,997,997,997,996,996,996,996,995,995,995,995,995,994,994,994,994,993,993,993,993,992,992,992,991,991,991,991,990,990,990,990,989,989,989,989,988,988,988,987,987,987,987,986,986,986,986,985,985,985,984,984,984,984,983,983,983,982,982,982,981,981,981,981,980,980,980,979,979,979,978,978,978,978,977,977,977,976,976,976,975,975,975,974,974,974,973,
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
volatile firstEncoderIndexPulseTestType myFirstEncoderIndexPulseTest = {0,0,1};		// this starts with the test running, since at startup, you don't know the absolute position of the motor post until an index pulse has happened.

volatile piType myPI;

volatile int poscnt = 0;
volatile int poscntOld = 0;
volatile int rotorFluxRPS_times16 = 0;

volatile unsigned int rotorFluxAngle = 1; 		// This is the rotor flux angle. In [0, 511]
volatile int RPS_times16 = 0; // range [-3200, 3200], where 3200 corresponds to 200rev/sec = 12,000RPM, and 0 means 0RPM.
volatile int currentSensorAmpsPerVoltTimes5 = DEFAULT_CURRENT_SENSOR_AMPS_PER_VOLT*5;


volatile int maxRPS_times16 = DEFAULT_MAX_RPS_TIMES16; // 3200 CORRESPONDS TO 12000RPM.

volatile unsigned int rGlobal = 0;
volatile long rGlobal_filtered_times65536 = 0L;//   
volatile int rGlobal_filtered = 0;//
volatile int voltageDiskExceeded = 0;

volatile int slipSpeedRPS_times16 = 0;
volatile int magnetizingCurrentAmps_times8 = 0;

volatile unsigned int counter1k = 0;
volatile unsigned int counter10k = 0;

volatile unsigned int faultBits = STARTUP_FAULT;
volatile int vRef1 = 512, vRef2 = 512;  // these are temporary values for "zero current feedback".  The real values will be computed later, but this is close, since zero current corresponds to 2.5v on the current sensor.

volatile int throttle = 0, rawThrottle = 0;
volatile int throttleFaultCounter = 0;

volatile int maxMotorCurrentNormalizedRegen = 0;
volatile int maxMotorCurrentNormalized = 0;
volatile int batteryCurrentNormalized = 0;
volatile int batteryAmps = 0;
volatile int maxBatteryCurrentNormalized = 0;
volatile int maxBatteryCurrentNormalizedRegen = 0;
volatile int normalizedToAmpsMultiplier = 0;

volatile int temperatureBasePlate = 0;

volatile int ADCurrent1 = 0, ADCurrent2 = 0;
volatile int newADValuesAvailable = 0;
volatile int currentMaxIterationsBeforeZeroCrossing = 20;		// used in the PI loop test.  How many iteratiosn is too many for Iq to go from 0 to IqRef?  I call it zero crossing, because I'm looking at the error = IqRef - Iq.

// _ADInterrupt() variables
volatile int i_alpha = 0;
volatile int i_beta = 0;
volatile int Id = 0;
volatile int Iq = 0;
volatile int Ia = 0, Ib = 0, Ic = 0, Ib_times2 = 0;
volatile int Vd = 0, Vq = 0;
volatile int v_alpha = 0;
volatile int v_beta = 0;
volatile int pdc1 = 0;
volatile int pdc2 = 0;
volatile int pdc3 = 0;
volatile int averageDuty = 0;
volatile int Va = 0, Vb = 0, Vc = 0;
volatile int IdRef = 0;	// in the range [0, 4096]
volatile int IdRefRef = 0;
volatile int IqRefRef = 0;
volatile int IqRef = 0; // in the range [-4096, 4096]
volatile int currentRadiusRefRef = 0;
volatile int currentRadiusRefRefOverSqrt2 = 0;
volatile int K = 0;
volatile long int KLong = 0L;

volatile int captureData = 0;
volatile int dataCaptureIndex = 0;


extern char intString[];

extern void u16_to_str(char *str, unsigned val, unsigned char digits);
extern int TransmitString(char* str);
extern void ShowMenu(void);
extern void ProcessCommand(void);
extern void InitUART2(void);
extern void StreamData(void);
extern volatile dataStream myDataStream;

void InitTimers();
void InitIORegisters(void);
void Delay(unsigned int);
void DelayTenthsSecond(int time);
void DelaySeconds(int time);
void InitADAndPWM();
void InitQEI();
void TurnOffADAndPWM();
void InitCNModule();
void InitPIStruct();
void ClearAllFaults();  // clear the flip flop fault and the desat fault.
void ClearDesatFault();
void ClearFlipFlop();
void ComputePositionAndSpeed();
void ComputePositionAndSpeedSensorless();
void SpaceVectorModulation();
void ClampVdVq();
void Delay1uS();
void GrabDataSnapshot();
void ComputeZeroCurrentOffsets();
void ChargeUpCapacitorBank();
void UpdateCounter1k();
void RunPITest();

void GetCurrentRadiusRefRef();
void UpdateDataStream();
void DisplayTestResults();
void CheckForFaults();
void DisplayFaultMessages();
void RunMotorSaliencyTest();

void __attribute__ ((__interrupt__,auto_psv)) _CNInterrupt(void);
void __attribute__ ((__interrupt__,auto_psv)) _ADCInterrupt(void);
void __attribute__ ((__interrupt__,auto_psv)) _MathError(void);
void __attribute__ ((__interrupt__,auto_psv)) _StackError(void);
void __attribute__ ((__interrupt__,auto_psv)) _AddressError(void);
void __attribute__ ((__interrupt__,auto_psv)) _OscillatorFail(void);

void MoveDataFromEEPromToRAM();
void EESaveValues();
void InitializeThrottleAndCurrentVariables();
void MoveToNextPIValues();
int unknownTriangleLeg(int c, int b);


int main() {
	InitIORegisters();
	InitTimers();  // Now timer1 is running at around 59KHz.
	DelayTenthsSecond(5); // Let voltages settle.

	MoveDataFromEEPromToRAM();  // load the saved configuation values, if any.
	InitCNModule();  // Turn on the change notification module.
	InitializeThrottleAndCurrentVariables();
	InitPIStruct();
	InitADAndPWM();		// Now the A/D is triggered by the pwm period, and the PWM interrupt is enabled.
	InitQEI();
	InitUART2();  // Now the UART is running.
	ComputeZeroCurrentOffsets();  // The current sensors have an offset of around 2.5v at zero amps.  So, what you do is, measure the A/D of the 2 phase currents like 256 times, and average it.  Then, use those 2 offsets for the rest of the time the controller is on.
	ChargeUpCapacitorBank();
	ClearAllFaults();	// The flip flop and desaturation detection faults start up in an unknown state. clear them.
	ShowMenu(); 	// serial show menu.
	while(1) {
		ProcessCommand();  // If there's a command to be processed, this does it.  haha.
		UpdateCounter1k();
		GetCurrentRadiusRefRef();
		UpdateDataStream();
		DisplayTestResults();
		CheckForFaults();
		DisplayFaultMessages();
		// let the interrupts take care of the rest...
		ClrWdt();  // kick the watchdog.  haha.  That's a Fran original.
 	}
}

//---------------------------------------------------------------------
// The ADC sample and conversion is triggered by the PWM period.
//---------------------------------------------------------------------
// This runs at 9.997kHz.
void __attribute__ ((__interrupt__,auto_psv)) _ADCInterrupt(void) {
	static volatile unsigned int rotorFluxAnglePlus90 = 0;
	static volatile unsigned int elapsedTimeInterrupt = 0;
	static volatile int cos_theta_times32768 = 0;
	static volatile int sin_theta_times32768 = 0;
	static volatile int tempVd = 0;
	static volatile int tempVq = 0;
	static volatile int rampRate = 1;
	static volatile unsigned int startTimeInterrupt = 0;
	static volatile long vBetaSqrt3_times32768 = 0;
	static volatile long v_alpha_times32768 = 0;
	static volatile int bigArrayCounter = 0;
//	static volatile int zeroThrottle = 0;
//	static volatile unsigned int zeroThrottleTimer = 0;

	startTimeInterrupt = TMR4;

    IFS0bits.ADIF = 0;  	// Interrupt Flag Status Register. Pg. 142 in F.R.M.
	// ADIF = A/D Conversion Complete Interrupt Flag Status bit.  
	// ADIF = 0 means we are resetting it so that an interrupt request has not occurred.

	counter10k++;	
	ComputePositionAndSpeed();

	// CH0 corresponds to ADCBUF0. etc...
	// CH0=AN7, CH1=AN0, CH2=AN1, CH3=AN2. 
	// AN0 = CH1 = ADThrottle
	// AN1 = CH2 = ADCurrent1
	// AN2 = CH3 = ADCurrent2
	// AN7 = CH0 = ADTemperature

	ADCurrent1 = ADCBUF2;
	ADCurrent2 = ADCBUF3;
	Ia = ADCurrent1;	// CH2 = ADCurrent1
	Ib = ADCurrent2;		// CH3 = ADCurrent2.

	Ia -= vRef1;  // vRef1 is just a constant found at the beginning of the program, approximately = 512, that changes the current feedback from being centered at 512 to centered at 0.  It's specific to current sensor #1.
	Ib -= vRef2;  // vRef2 is just a constant found at the beginning of the program, approximately = 512, that changes the current feedback from being centered at 512 to centered at 0.  It's specific to current sensor #2.
	// So, you must change the interval to [-4096, 4096], so as to match the throttle range below to make feedback comparable with commanded current. So...

	Ia <<= 4;	// Ia is now in [-4096, 4096] if it was in  [-256, 256].  In other words, if it was in [-2*LEM Rating, 2*LEM Rating]. 
	Ib <<= 4;   // Ib is now in [-4096, 4096] if it was in  [-256, 256].  In other words, if it was in [-2*LEM Rating, 2*LEM Rating]. 
	Ic = -Ia - Ib;
	Ib_times2 = (Ib << 1);

	newADValuesAvailable = 1;
	// limit current radius reference outisde this loop.
	if (myPI.testRunning) {
		RunPITest();
	}
	else if (myMotorSaliencyTest.testRunning) {
		RunMotorSaliencyTest();
	}
	///////////////////////////////////////////////////////////////////////////////////////////////
	// Clarke transform:
	//  	First, take the 3 vectors, 120 degrees apart, and add them to
	// 		get a new vector, and project that vector onto the x and y axis.  The x-axis component is called i_alpha.  y-axis component is called i_beta.
	// clarke transform, scaled down by 2/3 to simplify it:
	// i_alpha = i_a
	// 1/sqrt(3) * 2^16 = 37837

	i_alpha = Ia;
	i_beta = __builtin_mulsu((int)(Ib_times2 + Ia), 37837u) >> 16;  // 1/sqrt(3) * (i_a + 2 * Ib).  

	// End of clarke transform.
	////////////////////////////////////////////////////////////////////////////////////////////////
	////////////////////////////////////////////////////////////////////////////////////////////////
	// Park transform:
	// rotorFluxAngle is normalized to something in [0, 511] electrical "degrees".
	// sin(theta + 90 degrees) = cos(theta).
	// I want the 2 angles to be in [0, 511] so I can use the lookup table.
	rotorFluxAnglePlus90 = ((rotorFluxAngle + 128) & 511);  // To advance 90 degrees on a scale of 0 to 511, you add 128, 
															// and then do "& 511" to make it wrap around if overflow occurred.
	
	cos_theta_times32768 = _sin_times32768[rotorFluxAnglePlus90];  // 
	sin_theta_times32768 = _sin_times32768[rotorFluxAngle];  // 
	// Park Transform:
	// Id = Ialpha*cos(theta) + Ibeta*sin(theta)
	// Iq = -Ialpha*sin(theta) + Ibeta*cos(theta)
	Id = (__builtin_mulss((int)i_alpha, (int)cos_theta_times32768) + __builtin_mulss((int)i_beta, (int)sin_theta_times32768)) >> 15; 	
	Iq = (__builtin_mulss((int)(-i_alpha), (int)sin_theta_times32768) + __builtin_mulss((int)i_beta,(int)cos_theta_times32768)) >> 15; 

	/////////////////////////////////////////////////////////////////////////////////////////////////
	// PI Loop:
	myPI.error_q = IqRef - Iq;
	myPI.error_d = IdRef - Id;
	
	myPI.errorSum_q += myPI.error_q - myPI.clampErrorVq;
	myPI.errorSum_d += myPI.error_d - myPI.clampErrorVd;

//	if (captureData == 1) {
//		bigArray1[dataCaptureIndex] = ;
//		bigArray2[dataCaptureIndex] = Vq;
//		if (dataCaptureIndex < 253) {
//			dataCaptureIndex++;
//		}
//		else {
//			captureData = 0;
//		}
//	}
	
//	if (IdRef == 0 && IqRef == 0 && Vd < 30 && Vd > -30 && Vq < 30 && Vq > -30) {  // this causes overcurrent faults when going back to zero throttle from nonzero throttle.  It works great in the case of an induction motor.  oh well.
//		zeroThrottleTimer++;
//		if (zeroThrottleTimer > 50000) {
//			zeroThrottle = 1;
////		}
//	}
//	if (IdRef != 0 || IqRef != 0) {
//		zeroThrottleTimer = 0;
//		zeroThrottle = 0;
//	}
//	if (zeroThrottle) {
//		myPI.pwm_d = 0;
//		myPI.errorSum_d = 0;
//		myPI.error_d = 0;
//		myPI.clampErrorVd = 0;
//		myPI.pwm_q = 0;
//		myPI.errorSum_q = 0;
//		myPI.error_q = 0;
//		myPI.clampErrorVq = 0;
//	}
//	else {
		myPI.pwm_d = (myPI.Kp * myPI.error_d) + (myPI.Ki*myPI.errorSum_d);
		myPI.pwm_q = (myPI.Kp * myPI.error_q) + (myPI.Ki * myPI.errorSum_q);
//	} // 13 is what it was.
	if (myPI.pwm_d > (MAX_VD_VQ << 13)) {
		myPI.pwm_d = (MAX_VD_VQ << 13);
		faultBits |= PI_OVERFLOW_FAULT;
	}
	else if (myPI.pwm_d < ((-MAX_VD_VQ) << 13)) {
		myPI.pwm_d = ((-MAX_VD_VQ) << 13);		
		faultBits |= PI_OVERFLOW_FAULT;
	}
	if (myPI.pwm_q > (MAX_VD_VQ << 13)) {
		myPI.pwm_q = (MAX_VD_VQ << 13);
		faultBits |= PI_OVERFLOW_FAULT;
	}
	else if (myPI.pwm_q < ((-MAX_VD_VQ) << 13)) {
		myPI.pwm_q = ((-MAX_VD_VQ) << 13);		
		faultBits |= PI_OVERFLOW_FAULT;
	}

	Vd = myPI.pwm_d >> 13;
	Vq = myPI.pwm_q >> 13;
	tempVd = Vd;
	tempVq = Vq;

	ClampVdVq();
	myPI.clampErrorVd = tempVd - Vd;
	myPI.clampErrorVq = tempVq - Vq;
	//	if (maxClampErrorVd < myPI.clampErrorVd) maxClampErrorVd = myPI.clampErrorVd;
	//	if (minClampErrorVd > myPI.clampErrorVd) minClampErrorVd = myPI.clampErrorVd;
	//	if (maxClampErrorVq < myPI.clampErrorVq) maxClampErrorVq = myPI.clampErrorVq;
	//	if (minClampErrorVq > myPI.clampErrorVq) minClampErrorVq = myPI.clampErrorVq;

	// should I have it go instantly to IqRefRef if IqRefRef is smaller in magnitude?
	if (IqRef < IqRefRef) {
		IqRef += rampRate;  // I want it to be a laxidaisical drift back so as to avoid harsh PI loop clamping.
		if (IqRef > IqRefRef) {
			IqRef = IqRefRef;
		}
	}
	else if (IqRef > IqRefRef) {
		IqRef -= rampRate;
		if (IqRef < IqRefRef) {
			IqRef = IqRefRef;
		}
	}

	// should I have it go instantly to IdRefRef if IdRefRef is smaller in magnitude?
	if (IdRef < IdRefRef) {
		IdRef += rampRate;
		if (IdRef > IdRefRef) {
			IdRef = IdRefRef;
		}
	}
	else if (IdRef > IdRefRef) {
		IdRef -= rampRate;
		if (IdRef < IdRefRef) {
			IdRef = IdRefRef;
		}
	}

	//////////////////////////////////////////////////////////////////////////////////
	// Inverse Park Transform:
	//	v_alpha_times32768 = (Vd*cos_theta_times32768 - Vq*sin_theta_times32768);	// shift right 15 because sin and cos have been shifted left by 15.
	//	vBeta =  (Vd*sin_theta_times32768 + Vq*cos_theta_times32768) >> 15;	//
	v_alpha_times32768 = __builtin_mulss((int)Vd, (int)cos_theta_times32768) - __builtin_mulss((int)Vq, (int)sin_theta_times32768);
	v_beta = (__builtin_mulss((int)Vd, (int)sin_theta_times32768) + __builtin_mulss((int)Vq, (int)cos_theta_times32768)) >> 15;
	//////////////////////////////////////////////////////////////////////////////////
	// Now do the inverse Clarke transform, with a scaling factor of 3/2 to simplify it.
	//  Va = v_alpha
	//	Vb = 1/2*(-v_alpha + sqrt(3)*vBeta)
	//  Vc = 1/2*(-v_alpha - sqrt(3)*vBeta);
	v_alpha = v_alpha_times32768 >> 15;
	Va = v_alpha; 
	//vBetaSqrt3_times32768 = (56756*vBeta);  // 56756 = sqrt(3)*(2^15).
	vBetaSqrt3_times32768 = __builtin_mulus(56756u, (int)v_beta);  // 56756 = sqrt(3)*(2^15).

	Vb = (-v_alpha_times32768 + vBetaSqrt3_times32768) >> 16;  // scaled up by 2^15, so shift down by 15.  But you also must divide by 2 at the end as part of the inverse clarke.  So, shift down by a total of 16.
	Vc = (-v_alpha_times32768 - vBetaSqrt3_times32768) >> 16;
	///////////////////////////////////////////////////////////////////////////////////
	// SpaceVectorModulation:
	// You now turn Va, Vb, Vc into duties for PDC1, PDC2, PDC3.  

#ifdef DEBUG_MODE
	PDC1 = 1000;
	PDC2 = 1000;
	PDC3 = 1000;
#else
	if (faultBits == 0) {  // check again before poceeding, since there could have been a fault just above.
		SpaceVectorModulation();
	}
	else {
		PDC1 = 0;
		PDC2 = 0;
		PDC3 = 0;
		myPI.error_d = 0l;
		myPI.pwm_d = 0l;  
		myPI.errorSum_d = 0l;
		myPI.error_q = 0l;
		myPI.pwm_q = 0l;  
		myPI.errorSum_q = 0l;		
	}
#endif
	elapsedTimeInterrupt = TMR4 - startTimeInterrupt;
}

int unknownTriangleLeg(int c, int b) {
	// 
	// assume that b and c are positive integers.
// This finds a = sqrt(c*c - b*b), where triangle a,b,c is a right triangle, and c is the hypotenuse.
// I have a lookup table for all possible sqrt(1024*1024 - b*b).
// So, let's say c = 512 & b = 75.  Before using the lookup table, you would have to scale things so that c = 1024.  If you double c and b, then you also double the answer.
// so, to get the true answer, you have to cut 'a' in half at the end.
// 
// newC = 1024.  newB = b*1024/c.  a = unknownTriangleLegLookup[newB];
	static volatile int newB = 0;
	static volatile int a = 0;
	if (c == 0) return 0;
	if (b >= c) return 0;
	if (b < 0) b = -b;
	newB = __builtin_divsd(((long)b) << 10, c);
	a = unknownTriangleLegLookup[newB];  // a = sqrt(1024*1024 - newB*newB).
	a = __builtin_mulss(a,c) >> 10; // Now, scale a back to what it should be.  a = a*c / 1024?
	return a;
}

void MoveToNextPIValues() {
	myPI.Kp += myPI.ratioKpKi;
	myPI.Ki += 1;
	myPI.error_d = 0l;
	myPI.pwm_d = 0l;  
	myPI.errorSum_d = 0l;

	myPI.error_q = 0l;
	myPI.pwm_q = 0l;  
	myPI.errorSum_q = 0l;	

	myPI.iteration = 0;
	myPI.zeroCrossingIndex = -1;
	IdRef = 0;
	IqRef = 0;
	myPI.previousTestCompletionTime = counter10k;	
}

void InitPIStruct() {
	IdRef = 0;
	IqRef = 0;
	myPI.Kp = (long)savedValues.Kp;
	myPI.Ki = (long)savedValues.Ki;
	myPI.error_d = 0l;
	myPI.pwm_d = 0l;  
	myPI.errorSum_d = 0l;

	myPI.error_q = 0l;
	myPI.pwm_q = 0l;  
	myPI.errorSum_q = 0l;

	myPI.testFinished = 0;
	myPI.testFailed = 0;
	myPI.testRunning = 0;
	myPI.ratioKpKi = 62; //savedValues2.ratioKpKi;
	myPI.zeroCrossingIndex = -1; // initialize to -1.
	myPI.iteration = 0; // how many times have you run the PI loop with the same Kp and Ki?  This is used in the PI auto loop tuning.
	myPI.maxIterationsBeforeZeroCrossing = currentMaxIterationsBeforeZeroCrossing; //20
	myPI.previousTestCompletionTime = counter10k;
}

void ComputePositionAndSpeed() {
	static volatile unsigned int rotorFluxAngle_times128 = 0;  // For fine control.
	static volatile long magCurrChange = 0L;
	static volatile long slipSpeedNumerator = 0L;
	static volatile int angleChange_times128 = 0;
	static volatile long magnetizingCurrentFine = 0L;
	static volatile int magnetizingCurrent = 0;
//	static volatile unsigned long tempLong = 0UL;
	static volatile /*unsigned*/ int temp = 0;
	static volatile int revCounter = 0;	// revCounter increments at 10kHz.  When it gets to 78, the number of ticks in POSCNT is extremely close to the revolutions per seoond * 16.
								// So, the motor mechanical speed will be computed every 1/128 seconds, and will have a range of [0, 3200], where 3200 corresponds to 12000rpm.	
	static int diffPos = 0;
	static long ticksPerSecInstantaneous = 0;
	
	static long ticksPerSecAverage_times256 = 0;
	static long ticksPerSecAverage = 0;
	static long tempLong = 0;

	if (myPI.testRunning) {
		rotorFluxAngle = 0;
		return;
	}
	switch(savedValues.motorType) {
		case AC_INDUCTION_MOTOR:	// use these on induction motors.
			// so dense... so glorious.  Covers positive and negative RPM for ACIM only.
			// 
			revCounter++;
			if (revCounter >= revCounterMax) { // 512 ticks per revolution for encoder.
				RPS_times16 = POSCNT;	// if POSCNT is 0x0FFFF due to THE MOTOR GOING BACKWARDS, RPS_times16 would be -1, since it's of type signed short.  So, it's all good.  Negative RPM is covered.
				POSCNT = 0;
				revCounter = 0;
				if (RPS_times16 > maxRPS_times16 || RPS_times16 < -maxRPS_times16) {  //
					faultBits |= OVERSPEED_FAULT;
				}
				else {
					faultBits &= ~OVERSPEED_FAULT;
				}
			}
			//;	 Physical form of equations:
			//;  Magnetizing current (amps):
			//;     Imag = Imag + (fLoopPeriod/fRotorTmConst)*(Id - Imag)
			//;
			//;  Slip speed in RPS:
			//;     VelSlipRPS = (1/fRotorTmConst) * (Iq/Imag) / (2*pi)
			//;
			//;  Rotor flux speed in RPS:
			//;     VelFluxRPS = iPoles * VelMechRPS + VelSlipRPS
			//;
			//;  Rotor flux angle (radians):
			//;     AngFlux = AngFlux + fLoopPeriod * 2 * pi * VelFluxRPS
			
			// ****For divide, use this:  	int quot =	 __builtin_divsd(long numerator, int denominator);****
			// ****For multiply, use this:  long prod =   __builtin_mulus(unsigned left,  int right);****  or muluu, or mulsu, or mulss.
			
			//; 1.  Magnetizing current (amps):
			//;     Imag = Imag + (fLoopPeriod/fRotorTmConst)*(Id - Imag)
			//      rotorTimeConstantArray[]'s entries have been scaled up by 2^18 to give more resolution for the rotor time constant.  I scaled by 18, because that allowed incrementing rotor time constant by 0.01 seconds.
			//	magnetizingCurrent += ((rotorTimeConstantArray1[myRotorTest.rotorTimeConstantIndex] * (Id - magnetizingCurrent))) >> 18;
			///////////////////////////////////////////////////////////////////////////
			
			magCurrChange = __builtin_mulus((unsigned int)rotorTimeConstantArray1[myRotorTest.timeConstantIndex], (int)(Id - magnetizingCurrent));
			if (magCurrChange > 0) {
				if (magnetizingCurrentFine < MAX_LONG_INT - magCurrChange) {
					magnetizingCurrentFine += magCurrChange;
				}
				else {
					magnetizingCurrentFine = MAX_LONG_INT;
					faultBits |= MC_OVERFLOW_FAULT;
				}
			}
			else {
				if (magnetizingCurrentFine > -MAX_LONG_INT - magCurrChange) {
					magnetizingCurrentFine += magCurrChange;
				}
				else {
					magnetizingCurrentFine = -MAX_LONG_INT;
					faultBits |= MC_OVERFLOW_FAULT;
				}
			}
			magnetizingCurrent = (int)(magnetizingCurrentFine >> 18);
			//	magnetizingCurrentAmps_times8 = __builtin_mulss((int)magnetizingCurrent, (int)currentSensorAmpsPerVoltTimes5) >> 11;  // 5/4*currentSensorAmpsPerVolt / 4096 * #ticks = amps.  So amps*8 cancels it down to >>11.

			////////////////////////////////////////////////////////////////////////////
			//; 2. To Compute Slip speed in RPS:
			//;    VelSlipRPS = (1/fRotorTmConst) * (Iq/Imag) / (2*pi)
			//     rotorTimeConstantArray2[] entries are 1/fRotorTmConst * 1/(2*pi) * 2^11.  I couldn't scale any higher than 2^11 so as to keep them integers. (this is not 100% true now.  haha.)
			//	   VelSlipRPS = (ARRAY[] * Iq) / Imag.
			//	   Let slipSpeedNumerator = (ARRAY[] * Iq).  Then, do the bit shift down first, and the divide by magnetizing current afterwards to prevent the loss of resolution.
			/////////////////////////////////////////////////////////////////////////////////////////////////////	
			if (magnetizingCurrent == 0) {
				return;  // there is no rotor flux angle, since there is no field.  So, keep the angle the same as it was before??
			}
			else if (Iq == 0) {
				slipSpeedRPS_times16 = 0;  // If the numerator is 0, the whole thing is zero.
			}
			else {  // magnetizingCurrent != 0, slipSpeedNumerator != 0
					slipSpeedNumerator = __builtin_mulus((unsigned int)rotorTimeConstantArray2[myRotorTest.timeConstantIndex], (int)Iq) >> 7; // Must scale down by 2^11 if you want units to be rev/sec.  But that's too grainy.  So, let's only scale down by 2^7 so you get slip speed in rev/sec * 16, rather than just rev/sec
				if (magnetizingCurrent > 0) {
					if (slipSpeedNumerator > 0L) {
						if (slipSpeedNumerator > __builtin_mulss((int)magnetizingCurrent,(int)MAX_SLIP_SPEED_RPS_TIMES16)) {
							slipSpeedRPS_times16 = MAX_SLIP_SPEED_RPS_TIMES16;  // must be positive slip speed
						}
						else {
							slipSpeedRPS_times16 = __builtin_divsd((long)slipSpeedNumerator, (int)magnetizingCurrent);  // must be positive slip speed.
						}
					}
					else { // if (slipSpeedNumerator < 0).  It can't be zero, since that case was already accounted for.
						if (-slipSpeedNumerator > __builtin_mulss((int)magnetizingCurrent,(int)MAX_SLIP_SPEED_RPS_TIMES16)) {
							slipSpeedRPS_times16 = -MAX_SLIP_SPEED_RPS_TIMES16;  // must end with negative slip speed.
						}
						else {
							slipSpeedRPS_times16 = __builtin_divsd((long)slipSpeedNumerator, (int)magnetizingCurrent);  // this is negative result.
						}
					}
				}
				else {  // magnetizingCurrent < 0
					if (slipSpeedNumerator > 0) {  // POS / NEG = NEG.
						if (slipSpeedNumerator > __builtin_mulss((int)(-magnetizingCurrent),(int)MAX_SLIP_SPEED_RPS_TIMES16)) {  //
							slipSpeedRPS_times16 = -MAX_SLIP_SPEED_RPS_TIMES16;  // must be negative slip speed.  pos/neg = neg.
						}
						else {
							slipSpeedRPS_times16 = __builtin_divsd((long)slipSpeedNumerator, (int)magnetizingCurrent);  // must be negative slip speed.
						}
					}
					else {  // slipSpeedNumerator < 0, magnetizingCurrent < 0.  So, slipSpeed will be positive below.
						if (slipSpeedNumerator < __builtin_mulss((int)magnetizingCurrent,(int)MAX_SLIP_SPEED_RPS_TIMES16)) {  // if it's more negative than the right hand side...
							slipSpeedRPS_times16 = MAX_SLIP_SPEED_RPS_TIMES16;  // must end with positive slip speed.  neg / neg = pos.
						}
						else {
							slipSpeedRPS_times16 = __builtin_divsd((long)slipSpeedNumerator, (int)magnetizingCurrent);  // this is positive result.
						}
					}
				}
			}
			///////////////////////////////////////////////////////////////////////////////////
			//; 3. Rotor flux speed in RPS:
			//;    VelFluxRPS = numPolePairs * VelMechRPS + VelSlipRPS
			//     RPS_times16 was gloriously found in the main interrupt. It is in [-3200, 3200], which means [-12000RPM, 12000RPM].  I will make sure that normal driving is positive rpm.
			//     savedValues2.numberOfPolePairs is 2 in the case of my motor, because the RPM is listed as 1700 with 60 Hz 3 phase input.  1 pole pair would list the rpm as around 3400 with 60 Hz 3 phase input.
			//	rotorFluxRPS_times16 = savedValues2.numberOfPolePairs * RPS_times16 + slipSpeedRPS_times16;  // There's no danger of integer overflow for 1 or 2 pole pairs, so just do normal multiply.
			
			rotorFluxRPS_times16 = savedValues2.numberOfPolePairs*RPS_times16 + slipSpeedRPS_times16;  // There's no danger of integer overflow, so just do normal multiply.  Larger number of pole pairs means lower rpm, so it all evens out.

			//;  Rotor flux angle (radians):
			//;     AngFlux = AngFlux + fLoopPeriod * 2 * pi * VelFluxRPS
			//;  Rotor flux angle (0 to 511 ticks):
			//      AngFlux = AngFlux + fLoopPeriod * 512 * VelFluxRPS.  
			//   Now, I don't have VelFluxRPS.  Too darn grainy.  I found rotorFluxRPS_times16 above.  So.....
			//      AngFlux = AngFlux + fLoopPeriod * 32 * rotorFluxRPS_times16, because 32 * 16 = 512.
			//   OK, fLoopPeriod = 0.0001 sec.  I don't want to divide here, so let's do a trick that is much faster.
			//   0.0001sec * 32 * 2^24 = 53687.09.  So, I'll just multiply by 53687, and shift down by 2^24 afterwards.  Actually, let's keep 2^7 worth of extra resolution, because angleChange was too grainy before.
			//	angleChange_times128 = (53687u * rotorFluxRPS_times16) >> 17;  // must shift down by 24 eventually, but let's keep a higher resolution here.  So, only shift down by 17.  Keeping 7 bits.
			angleChange_times128 = __builtin_mulus(53687u, (int)rotorFluxRPS_times16) >> 17;  // must shift down by 24 eventually, but let's keep a higher resolution here.  So, only shift down by 17.  Keeping 7 bits.
			// angleChange_times128 must be in [-5242, 5242] assuming all the clamping I'm doing above.
			rotorFluxAngle_times128 += (unsigned)angleChange_times128;  // if it overflows, so what.  it will wrap back around.  To go from [0,65536] --> [0,512], divide by by 128.  higher resolution rotor flux angle saved here.
			rotorFluxAngle = (rotorFluxAngle_times128 >> 7);
		break;
		case TOYOTA_MGR_MOTOR:	// Toyota MGR hybrid motor does 2 electrical revolutions per 1 resolver revolution.
			temp = POSCNT;			// it will be in [0,1023).  4 times the 256 ticks coming from the resolver to encoder board.  Two electrical revolutions per index pulse.  It's my resolver to encoder board, so I ought to know!!!  haha.
			if (temp < 10000) { // I initialize POSCNT to an absurdly big value (15000).  It won't be in that range for long though.  But during this time, it could vary from around 14500 up to 15500.  As soon as an index pulse comes along, it will forever be trapped in [0, 511].
				myFirstEncoderIndexPulseTest.testRunning = 0; // poscnt is in [0,1023].  But the actual electrical angle is in [0,511]
				temp += myAngleOffsetTest.currentAngleOffset; 	// currentAngleOffset was found back when the motor had to be configured.  It is normalized to units of [0,511] electrical "degrees". 
			}
			else {  // there hasn't been an index pulse yet.  
				temp += myFirstEncoderIndexPulseTest.currentAngleOffset; 	// currentAngleOffset was found back when the motor had to be configured.  It is in units of [0,511] electrical "degrees". 
			}
			temp &= 511;		// Now, rotorFluxAngle is once again inside [0,511].
			rotorFluxAngle = temp;  // rotorFluxAngle can't be negative.
				// There are NUM_POLE_PAIRS index pulses per mechanical revolution when using the resolver to encoder board ONLY FOR THE LEAF MOTOR!!!!  For the toyota motor, there are 2

			// permanent magnet AC motor mechanical speed computation.
			// do this later.
			poscnt = POSCNT;
			diffPos = poscnt - poscntOld; // if this is > 512, make it diffPos - 1024. That way, let's say poscnt just went from 0 to 1023 (negative rotation).  We can call that diffPos = -1.
			poscntOld = poscnt;
			if (diffPos > 512) { // assume negative rotation.  
				diffPos = diffPos - 1024;
			}
			else if (diffPos < -512) { // For example, let's say poscntOld was 511, and now poscnt is 0 (positive rotation).  We want diffPos to be 1.  So, we do diffPos + 512.
				diffPos = diffPos + 1024; // 
			}
			ticksPerSecInstantaneous = __builtin_mulss(10000,(int)diffPos);  // This will be very erratic.  Wild swings, so smooth it out below with a filter that takes almost 1/50sec to converge to within 99.9%.
			ticksPerSecAverage_times256   	//= (63*ticksPerSecAverage_times64)/64 + 1*ticksPerSecInstantaneous) / 64 * 64;
									 		//= (64*(ticksPerSecAverage_times64/64) - 1*ticksPerSecAverage + 1*ticksPerSecInstantaneous) / 64 * 64
									= ticksPerSecAverage_times256 - ticksPerSecAverage + (long)ticksPerSecInstantaneous;
			ticksPerSecAverage = ticksPerSecAverage_times256 >> 8;
			// Below line assumes 512 ticks per electrical revolution.  The resolver to encoder has 256 ticks, and then I do 4 times the resolution.  But then the stupid toyota MGR does 2 electrical revolutions per index pulse!!  So, 1024 ticks per 2 electrical revolutions.  So, 512 ticks per electrical revolution.
			RPS_times16 = __builtin_divsd((long)ticksPerSecAverage, (int)(savedValues2.numberOfPolePairs << 5));	//  x ticks/sec * mechanicalRevolutions/(polePairs * 512 ticks) = mechanicalRevolutions/sec.  16mechanicalRev/(16sec) = RPS_times16.  There are 512 ticks per electrical revolution with my resolver to encoder after the resolution quadrupling that happens when I intiialize the quadrature encoder interface.
		break;
		case NISSAN_LEAF_MOTOR:
			temp = POSCNT;		// it will be in [0,512).  It's my resolver to encoder board, so I ought to know!!!  haha.
		
			if (temp < 10000) { // I initialize POSCNT to an absurdly big value (15000).  It won't be in that range for long though.  But during this time, it could vary from around 14500 up to 15500.  As soon as an index pulse comes along, it will forever be trapped in [0, 511].
				myFirstEncoderIndexPulseTest.testRunning = 0;
				temp += myAngleOffsetTest.currentAngleOffset; 	// currentAngleOffset was found back when the motor had to be configured.  It is in units of [0,511] electrical "degrees". 
				temp &= 511;		// Now, rotorFluxAngle is once again inside [0,511].
				rotorFluxAngle = temp;  // rotorFluxAngle can't be negative.
				// There are NUM_POLE_PAIRS index pulses per mechanical revolution when using the resolver to encoder board WITH THE LEAF MOTOR!!  The friggen toyota MGR has 2 index pulses in 4 electrical revolutions, and in 1 mechanical revolution.
			}
			else {  // there hasn't been an index pulse yet.  
				temp += myFirstEncoderIndexPulseTest.currentAngleOffset; 	// currentAngleOffset was found back when the motor had to be configured.  It is in units of [0,511] electrical "degrees". 
				temp &= 511;		// Now, rotorFluxAngle is once again inside [0,511].
				rotorFluxAngle = temp;  // rotorFluxAngle can't be negative.
			}
			poscnt = POSCNT;		// poscnt is used elsewhere in the program.  Don't modify it like you did with 'temp'.
			diffPos = poscnt - poscntOld; // if this is > 256, make it diffPos - 512. That way, let's say poscnt just went from 0 to 511 (negative rotation)
			poscntOld = poscnt;
			if (diffPos > 255) { // assume negative rotation.  For example, maybe poscntOld was 0 and now poscnt is 511.  diffPos would be 511.
				diffPos = diffPos - 512;
			}
			else if (diffPos < -255) { // For example, let's say poscntOld was 511, and now poscnt is 0 (positive rotation).  We want diffPos to be 1.  So, we do diffPos + 512.
				diffPos = diffPos + 512;
			}
			ticksPerSecInstantaneous = __builtin_mulss(10000,(int)diffPos);  // This will be very erratic.  Wild swings, so smooth it out below with a filter that takes almost 1/50sec to converge to within 99.9%.
			ticksPerSecAverage_times256   	//= (63*ticksPerSecAverage_times64)/64 + 1*ticksPerSecInstantaneous) / 64 * 64;
									 		//= (64*(ticksPerSecAverage_times64/64) - 1*ticksPerSecAverage + 1*ticksPerSecInstantaneous) / 64 * 64
									= ticksPerSecAverage_times256 - ticksPerSecAverage + (long)ticksPerSecInstantaneous;
			ticksPerSecAverage = ticksPerSecAverage_times256 >> 8;
			// Below line assumes 512 ticks per electrical revolution.  The resolver to encoder has 256 ticks from that board I made, and then I double the resolution when it initizlizes the Quadrature Encoder Interface.
			RPS_times16 = __builtin_divsd((long)ticksPerSecAverage, (int)(savedValues2.numberOfPolePairs << 5));	//  x ticks/sec * mechanicalRevolutions/(polePairs * 512 ticks) = mechanicalRevolutions/sec.  16mechanicalRev/(16sec) = RPS_times16.  There are 512 ticks per electrical revolution with my resolver to encoder after the resolution doubling that happens when I intiialize the quadrature encoder interface.
		break;
		case PERMANENT_MAGNET_MOTOR_WITH_ENCODER:
			// There are 'n' POSCNT values that would work in [0, NUM_ENCODER_TICKS*4], where 'n' is the number of pole pairs.
			// POSCNT is in [0, NUM_ENCODER_TICKS*4].  An index pulse resets POSCNT back to zero, or to MAX_POSCNT if counting down.
			// 
			temp = POSCNT;  // POSCNT = encoderTicks * 4.

			if (temp < 10000) { // I initialize POSCNT to an absurdly big value (15000).  It won't be in that range for long though.  But during this time, it could vary from around 14500 up to 15500.  As soon as an index pulse comes along, it will forever be trapped in [0, 511].
				myFirstEncoderIndexPulseTest.testRunning = 0;

				tempLong = __builtin_muluu((unsigned int)temp,(unsigned int)savedValues2.numberOfPolePairs) << 7; 	// OK, this is friggen confusing.  You have to chop up [0, MAXCNT] into numberOfPolePairs pieces.  Then, you have to find what point POSCNT is at inside of one of those pieces.  Then, the rotor flux angle is basically where you are in that interval, on a normalized scale of [0, 511]																												// temp = temp * numberOfPolePairs * 128.  Multiply by 128 because temp/4 is the number of encoder ticks. 
				temp = __builtin_divud((unsigned long)tempLong, (unsigned int)savedValues2.encoderTicks);
				temp += myAngleOffsetTest.currentAngleOffset;
				rotorFluxAngle = temp & 511;
			}
			else {  // there hasn't been an index pulse yet. 
				tempLong = __builtin_muluu((unsigned int)temp,(unsigned int)savedValues2.numberOfPolePairs) << 7; 	// OK, this is friggen confusing.  You have to chop up [0, MAXCNT] into numberOfPolePairs pieces, where each piece is of width [0,511].  Then, you can quickly find the normalized rotor flux angle in [0,511].																												// temp = temp * numberOfPolePairs * 128.  Multiply by 128 because temp/4 is the number of encoder ticks. 
				temp = __builtin_divud((unsigned long)tempLong, (unsigned int)savedValues2.encoderTicks);
				temp += myFirstEncoderIndexPulseTest.currentAngleOffset; 	// currentAngleOffset was found back when the motor had to be configured.  It is in units of [0,511] electrical "degrees". 
				rotorFluxAngle = temp & 511; 
			}

			poscnt = POSCNT;		// poscnt is used elsewhere in the program.  Don't modify it like you did with 'temp'.
			diffPos = poscnt - poscntOld; // if this is > , make it diffPos - 512. That way, let's say poscnt just went from 0 to 511 (negative rotation)
			poscntOld = poscnt;
			if (diffPos > (savedValues2.encoderTicks << 1)) { // assume negative rotation.  For example, maybe poscntOld was 0 and now poscnt is encoderTicks * 4.  diffPos would be encoderTicks*4.
				diffPos = diffPos - (savedValues2.encoderTicks << 2);
			}
			else if (diffPos < -(savedValues2.encoderTicks << 1)) { // For example, let's say poscntOld was 511, and now poscnt is 0 (positive rotation).  We want diffPos to be 1.  So, we do diffPos + 512.
				diffPos = diffPos + (savedValues2.encoderTicks << 2);
			}
			ticksPerSecInstantaneous = __builtin_mulss(10000,(int)diffPos);  // This will be very erratic.  Wild swings, so smooth it out below with a filter that takes almost 1/50sec to converge to within 99.9%.
			ticksPerSecAverage_times256   	//= (63*ticksPerSecAverage_times64)/64 + 1*ticksPerSecInstantaneous) / 64 * 64;
									 		//= (64*(ticksPerSecAverage_times64/64) - 1*ticksPerSecAverage + 1*ticksPerSecInstantaneous) / 64 * 64
									= ticksPerSecAverage_times256 - ticksPerSecAverage + (long)ticksPerSecInstantaneous;
			ticksPerSecAverage = ticksPerSecAverage_times256 >> 8;
			// ticks/sec * rev/ticks * 16 = rev/sec * 16 = ticksPerSecAverage * rev / (savedValues2.encoderTicks * 4) * 16 = ticksPerSecAverage * 4 / savedValues2.encoderTicks.  
			RPS_times16 = __builtin_divsd(ticksPerSecAverage << 2, savedValues2.encoderTicks);	//  x ticks/sec * mechanicalRevolutions/(polePairs * 512 ticks) = mechanicalRevolutions/sec.  16mechanicalRev/(16sec) = RPS_times16.  There are 512 ticks per electrical revolution with my resolver to encoder after the resolution doubling that happens when I intiialize the quadrature encoder interface.

		break;
	}
}

void ClampVdVq() {
	static volatile int VdPos, VqPos, small, big;
	static volatile int i;
	static volatile unsigned int fastDist;
	static volatile unsigned int r;
	static volatile unsigned int scale;
	static volatile int IdRefNew = 0;
	static volatile int IqRefNew = 0;

	if (Vd == 0 && Vq == 0) return;  // Forgetting to do this caused me a lot of annoyances.  Divide by zero danger below.

	if (Vd < 0) VdPos = -Vd;
	else VdPos = Vd;
	if (Vq < 0) VqPos = -Vq;
	else VqPos = Vq;

	if (VqPos < VdPos) {
		small = VqPos;
		big = VdPos;
	}
	else {
		small = VdPos;
		big = VqPos;
	}
	i = __builtin_divsd(((long)small) << 10, (int)big);   // small * 1024 / big gives an index from 0 to 1024 inclusive.
	fastDist = (unsigned int)((small + big - (small >> 1) - (small >> 2)) + (small >> 4));
	// fastDist must be in [0, 19687*2??]
	r = (__builtin_muluu((unsigned)distCorrection[i], (unsigned)fastDist) >> 15);  // scale down by 2^15 since distCorrection was scaled up by 2^15.
	rGlobal = r;

	rGlobal_filtered_times65536   	//= (15*rGlobal_filtered_times65536/65536 + 1*rGlobal) / 16 * 65536;
							 		//= (16*rGlobal_filtered_times65536/65536 - 1*rGlobal_filtered + 1*rGlobal) / 16 * 65536
									  = ((rGlobal_filtered_times65536 >> 12) - ((long)rGlobal_filtered) + ((long)rGlobal)) << 12;
	rGlobal_filtered = rGlobal_filtered_times65536 >> 16;

	if (r > R_MAX) {
		voltageDiskExceeded = 1;  // just a flag to let the rest of the program know that we just ran out of voltage.
		scale = __builtin_divud((unsigned long)R_MAX_TIMES_65536, (unsigned)r);
		small = (int)(__builtin_mulsu((int)small, (unsigned)scale) >> 16);
		big = (int)(__builtin_mulsu((int)big, (unsigned)scale) >> 16);
		IqRefNew = (int)(__builtin_mulsu((int)IqRef, (unsigned)scale) >> 16);
		IdRefNew = (int)(__builtin_mulsu((int)IdRef, (unsigned)scale) >> 16);  // what if I only did this to IdRef instead of both of them?  Then it would be field weakening.  I'll compare later.
		IqRef = IqRefNew + (__builtin_mulus(3,IqRef - IqRefNew) >> 2);
		IdRef = IdRefNew + (__builtin_mulus(3,IdRef - IdRefNew) >> 2);
	}
	else {
		voltageDiskExceeded = 0;
		return;
	}
	if (VqPos < VdPos) {
		if (Vq < 0) {
			Vq = -small;
		}
		else {
			Vq = small;
		}
		if (Vd < 0) {
			Vd = -big;
		}
		else {
			Vd = big;
		}
	}
	else {  // VdPos <= VqPos.  Now, Vd goes with small, and Vq goes with big.  watch the sign though.
		if (Vd < 0) {
			Vd = -small;
		}
		else {
			Vd = small;
		}
		if (Vq < 0) {
			Vq = -big;
		}
		else {
			Vq = big;
		}
	}
}

void SpaceVectorModulation() { 
	// faster way:
	if (Va <= Vb) {
		// 3 possibilities:
		// Va <= Vb <= Vc
		// Vc <= Va <= Vb
		// Va <= Vc <= Vb
		if (Va <= Vc) {  // Va is smallest.
			pdc1 = 0;
			pdc2 = Vb - Va;
			pdc3 = Vc - Va;
		}
		else { // Vc is smallest
			pdc1 = Va-Vc;
			pdc2 = Vb-Vc;
			pdc3 = 0;
		}
	}
	else {
		// 3 possibilities:
		// Vb <= Va <= Vc
		// Vb <= Vc <= Va
		// Vc <= Vb <= Va
		if (Vb <= Vc) { // Vb is smallest.
			pdc1 = Va-Vb;
			pdc2 = 0;
			pdc3 = Vc-Vb;
		}
		else {  // Vc is smallest.
			pdc1 = Va-Vc;
			pdc2 = Vb-Vc;
			pdc3 = 0;			
		}
	}

// Equivalent slower code below //////////////////
/*
	if (Vc <= Va && Vc <= Vb) {  // Vc is smallest
		// Q1, Q2
		pdc1 = Va-Vc;
		pdc2 = Vb-Vc;
		pdc3 = 0;
	}
	else if (Va <= Vb && Va <= Vc) { // Va is smallest 
		// Q3, Q4
		pdc1 = 0;
		pdc2 = Vb - Va;
		pdc3 = Vc - Va;
	}
	else { // Vb is smallest.
		// Q5, Q6
		pdc1 = Va-Vb;
		pdc2 = 0;
		pdc3 = Vc-Vb;
	}
*/
	if (pdc1 > MAX_DUTY) {
		pdc1 = MAX_DUTY;
	}
	if (pdc2 > MAX_DUTY) {
		pdc2 = MAX_DUTY;
	}
	if (pdc3 > MAX_DUTY) {
		pdc3 = MAX_DUTY;
	}
	// pdc1, 2, and 3 can never be negative because of above.  So, don't bother to test that.
	PDC1 = pdc1;
	PDC2 = pdc2;
	PDC3 = pdc3;
}

void ClearAllFaults() {
	ClearDesatFault();
	ClearFlipFlop();
}

void ClearFlipFlop() {
	O_LAT_CLEAR_FLIP_FLOP = 0;  // Really like 100nS would be enough.
	Delay1uS();
	O_LAT_CLEAR_FLIP_FLOP = 1;	
}

void ClearDesatFault() {	// reset must be pulled low for at least 1.2uS.
	static volatile int i = 0;
	O_LAT_CLEAR_DESAT = 0; 	// FOD8316 Datasheet says low for at least 1.2uS.  But then the stupid fault signal may not be cleared for 20 whole uS!
	Delay1uS(); Delay1uS(); Delay1uS();
	O_LAT_CLEAR_DESAT = 1;

	for (i = 0; i < 30; i++) {  // Now, let's waste more than 30uS waiting around for the desat fault signal to be cleared.
		Delay1uS();
	} // 30uS better be long enough!
}
void Delay1uS() {  // Assuming 30MIPs.
	Nop(); Nop(); Nop(); Nop();	Nop(); Nop(); Nop(); Nop();	Nop(); Nop(); Nop(); Nop();	Nop(); Nop(); Nop();
	Nop(); Nop(); Nop(); Nop();	Nop(); Nop(); Nop(); Nop();	Nop(); Nop(); Nop(); Nop();	Nop(); Nop(); Nop();
}

void InitTimers() {
	T1CON = 0;  // Make sure it starts out as 0.
	T1CONbits.TCKPS = 0b11;  // prescale of 256.  So, timer1 will run at 115200Hz if Fcy is 7.3728*4 MHz.
	PR1 = 0xFFFF;  // 
	T1CONbits.TON = 1; // Start the timer.

	T2CONbits.T32 = 1;  // 32 bit mode.
	T2CONbits.TCKPS = 0b11;  // 1:1 prescaler.
	T2CONbits.TCS = 0;  	// use internal 15MHz Fcy for the clock.
	PR3 = 0x0FFFF;		// HIGH 16 BITS.
	PR2 = 0x0FFFF;		// low 16 bits.
	// Now, TMR3:TMR2 makes up the 32 bit timer, running at 58.6KHz.

	T4CONbits.T32 = 1;  // 32 bit mode.
	T4CONbits.TCKPS = 0b00;  // 1:1 prescaler.
	T4CONbits.TCS = 0;  	// use internal 15MHz Fcy for the clock.
	PR5 = 0x0FFFF;		// HIGH 16 BITS.
	PR4 = 0x0FFFF;		// low 16 bits.

	T2CONbits.TON = 1;	// Start the timer.
	T4CONbits.TON = 1;	// Start the timer.

	TMR3 = 0;  	// Timer3:Timer2 high word
	TMR5 = 0;	// Timer5:Timer4 high word

	TMR2 = 0;  	// Timer3:Timer2 low word
	TMR4 = 0;	// Timer5:Timer4 low word
}	

// Assuming a 30MHz clock, one tick is 1/(58594*2) seconds.
void Delay(unsigned int time) {
	static volatile unsigned int temp;
	temp = TMR1;	
	while (TMR1 - temp < time) {
		ClrWdt();
	}
}
void DelaySeconds(int time) {
	static volatile int i;
	for (i = 0; i < time; i++) { 
		Delay(58594u);  // 0.5 second.
		Delay(58594u);  // 0.5 second.
	}
}
void DelayTenthsSecond(int time) {
	static volatile int i;
	for (i = 0; i < time; i++) { 
		Delay(5859*2);  // 58594*2 ticks in Delay is 1 second.  So, 1/10 of that.
	}
}

void InitCNModule() {
	CNEN1bits.CN0IE = 1;  // overcurrent fault.
	CNEN1bits.CN1IE = 1;  // desat fault.

	CNPU1bits.CN0PUE = 0; // Make sure internal pull-up is turned OFF on CN0.
	CNPU1bits.CN1PUE = 0; // Make sure internal pull-up is turned OFF on CN1.

	_CNIF = 0;  // Clear change notification interrupt flag just to make sure it starts cleared.
	_CNIP = 3;  // Set the priority level for interrupts to 3.
	_CNIE = 1;  // Make sure interrupts are enabled.
}

void __attribute__((__interrupt__, auto_psv)) _CNInterrupt(void) {
	IFS0bits.CNIF = 0;  // clear the interrupt flag.

	if (I_PORT_DESAT_FAULT == 0) {  // It just became 0 like 2Tcy's ago.
		faultBits |= DESAT_FAULT;
	}
	if (I_PORT_OVERCURRENT_FAULT == 0) {
		faultBits |= OVERCURRENT_FAULT;
	}
}

void InitIORegisters() {
	I_TRIS_THROTTLE = 1;		// 1 means configure as input.  A/D throttle.
	I_TRIS_CURRENT1	= 1;		// 1 means configure as input.  A/D current 1.
	I_TRIS_CURRENT2	= 1;		// 1 means configure as input.  A/D current 2.
	I_TRIS_INDEX	= 1;		// 1 means configure as input.  encoder index.  1 pulse per revolution.
	I_TRIS_QEA		= 1;		// 1 means configure as input.  encoder QEA
	I_TRIS_QEB		= 1;		// 1 means configure as input.  encoder QEB
	O_TRIS_CLEAR_FLIP_FLOP = 0;	// 0 means configure as output. clear flip flop.
	O_LAT_CLEAR_FLIP_FLOP = 1;  // bring LOW, then HIGH to clear the flip flop.

	_TRISF0 = 0;				// DEBUGGING PIN.  configure as output.
	_LATF0 = 0;					// initialize it as low.

	I_TRIS_TEMPERATURE = 1;	// 1 means configure as input.  A/D temperatureBasePlate.
	I_TRIS_REGEN_THROTTLE = 1;	// 1 means configure as input.  A/D regen throttle.
	I_TRIS_DESAT_FAULT = 1;		// 1 means configure as input.  desat fault.
	I_TRIS_OVERCURRENT_FAULT = 1;	// 1 means configure as input. overcurrent fault.
	I_TRIS_UNDERVOLTAGE_FAULT = 1;	// 1 means configure as input.  undervoltage fault.
	O_TRIS_LED = 0; 			// 0 means configure as output.  Status LED.
	O_LAT_LED = 1; 				 // high means turn ON the LED.
	O_TRIS_PRECHARGE_RELAY = 0;	// 0 means configure as output.  precharge relay control.
	O_LAT_PRECHARGE_RELAY = 0;	// HIGH means turn ON the precharge relay.
	I_TRIS_GLOBAL_FAULT	= 1;	
	O_TRIS_CONTACTOR = 0;		// 
	O_LAT_CONTACTOR = 0;	
	
	O_TRIS_CLEAR_DESAT = 0;	
	O_LAT_CLEAR_DESAT = 1;		// Bring low then high to clear desat.
	
	O_TRIS_PWM_3H = 0;		// 0 means configure as output.
	O_LAT_PWM_3H = 0;		// Low means OFF.
	
	O_TRIS_PWM_3L = 0;		// 0 means configure as output.
	O_LAT_PWM_3L = 0;		// Low means OFF.
			
	O_TRIS_PWM_2H = 0;		// 0 means configure as output.
	O_LAT_PWM_2H = 0;		// Low means OFF.
		
	O_TRIS_PWM_2L = 0;		// 0 means configure as output.
	O_LAT_PWM_2L = 0;		// Low means OFF.
	
	O_TRIS_PWM_1H = 0;		// 0 means configure as output.
	O_LAT_PWM_1H = 0;		// Low means OFF.
	
	O_TRIS_PWM_1L = 0;		// 0 means configure as output.
	O_LAT_PWM_1L = 0;		// Low means OFF.
	
	ADPCFG = 0b1111111001111000;  // 0 is analog.  1 is digital.
}

void TurnOffADAndPWM() {
	ADCON1bits.ADON = 0; // Pg. 416 in F.R.M.  Under "Enabling the Module".  Turn it off for a moment.
	PWMCON1 = 0;
	O_LAT_PWM_1H = 0;
	O_LAT_PWM_2H = 0;
	O_LAT_PWM_3H = 0;
	O_LAT_PWM_1L = 0;
	O_LAT_PWM_2L = 0;
	O_LAT_PWM_3L = 0;
	DTCON1 = 0;
	PTCON = 0;
	SEVTCMP = 0;
	ADCON1 = 0;
	ADCON2 = 0;
	ADCON3 = 0;
	ADCHS = 0;
}

void InitADAndPWM() {
    ADCON1bits.ADON = 0; // Pg. 416 in F.R.M.  Under "Enabling the Module".  Turn it off for a moment.

	// PWM Initialization

	PTPER = 1474;	// 29,491,200/((PTPER + 1)*2) = 9997Hz. 
	PDC1 = 0;
	PDC2 = 0;
	PDC3 = 0;

	PWMCON1 = 0b0000000000000000; 			// Pg. 339 in FRM.
	PWMCON1bits.PEN1H = 1; // enabled. Enables pwm1h.  That's not the correct procedure captain!  Put your hand on the key sir!  I'm sorry... I'm so sorry.. Put your hand on the key sir!  -War Games.
	PWMCON1bits.PEN1L = 1; // enabled. Enables pwmll.
	PWMCON1bits.PEN2H = 1; // enabled.
	PWMCON1bits.PEN2L = 1; // enabled.
	PWMCON1bits.PEN3H = 1; // enabled.
	PWMCON1bits.PEN3L = 1; // enabled. 
	
	PWMCON2 = 0;

    DTCON1 = 0;     		// Pg. 341 in Family Reference Manual. 
	DTCON1bits.DTAPS = 0b10;  // deadtime unit A prescale is 4*Tcy.
	DTCON1bits.DTA = 15;  	// 15 CLOCK periods.  That is 4*15*Tcy = 2uS of dead time assuming 30MHz.

//    FLTACON = 0b0000000010000001; // Pg. 343 in Family Reference Manual. The Fault A input pin functions in the cycle-by-cycle mode.

	PTCON = 0x8002;         // Pg. 337 in FRM.  Enable PWM for center aligned operation.
							// PTCON = 0b1000000000000010;  Pg. 337 in Family Reference Manual.
							// PTEN = 1; PWM time base is ON
							// PTSIDL = 0; PWM time base runs in CPU Idle mode
							// PTOPS = 0000; 1:1 Postscale
							// PTCKPS = 00; PWM time base input clock period is TCY (1:1 prescale)
							// PTMOD = 10; PWM time base operates in a continuous up/down counting mode

	// SEVTCMP: Special Event Compare Count Register 
    // Phase of ADC capture set relative to PWM cycle: 0 offset and counting up
    SEVTCMP = 2;        // Cannot be 0 -> turns off trigger (Missing from doc)
						// SEVTCMP = 0b0000000000000010;  Pg. 339 in Family Reference Manual.
						// SEVTDIR = 0; A special event trigger will occur when the PWM time base is counting upwards and...
						// SEVTCMP = 000000000000010; If SEVTCMP == PTMR<14:0>, then a special event trigger happens.


	// ============= ADC - Measure 
	// ADC setup for simultanous sampling
	// AN0 = CH1 = Throttle;
	// AN1 = CH2 = Current1;
	// AN2 = CH3 = Current2;
	// AN8 = CH0 = regen throttle;	// trade between these 2
	// AN7 = CH0 = Temperature;		// trade between these 2.

	ADCON1 = 0;  // Starts this way anyway.  But just to be sure.   

    ADCON1bits.FORM = 0;  // unsigned integer in the range 0-1023
    ADCON1bits.SSRC = 0b011;  // Motor Control PWM interval ends sampling and starts conversion

    // Simultaneous Sample Select bit (only applicable when CHPS = 01 or 1x)
    // Samples CH0, CH1, CH2, CH3 simultaneously (when CHPS = 1x)
    // Samples CH0 and CH1 simultaneously (when CHPS = 01)
    ADCON1bits.SIMSAM = 1; 
 
    // Sampling begins immediately after last conversion completes. 
    // SAMP bit is auto set.
    ADCON1bits.ASAM = 1;  

	ADCON2 = 0; // Pg. 407 in F.R.M.
    // Pg. 407 in F.R.M.
    // Samples CH0, CH1, CH2, CH3 simultaneously when CHPS = 1x
    ADCON2bits.CHPS = 0b10; // VCFG = 000; This selects the A/D High voltage as AVdd, and A/D Low voltage as AVss.
						 // SMPI = 0000; This makes an interrupt happen every time the A/D conversion process is done (for all 4 I guess, since they happen at the same time.)
						 // ALTS = 0; Always use MUX A input multiplexer settings
						 // BUFM = 0; Buffer configured as one 16-word buffer ADCBUF(15...0)


 	ADCON3 = 0; // Pg. 408 in F.R.M.
    // Pg. 408 in F.R.M.
    // A/D Conversion Clock Select bits = 16 * Tcy.  (31+1) * Tcy/2 = 16*Tcy.
	// The A/D conversion of 4 simultaneous conversions takes 4*12*A/D clock cycles.  The A/D clock is selected to be 4*Tcy.
    // So, it takes about 4*12*16*Tcy to complete 4 A/D conversions. That's 51.2uS. The pwm period is 100uS, since it's 10kHz.
	ADCON3bits.ADCS = 31;  // 16Tcy.


    // ADCHS: ADC Input Channel Select Register 
    ADCHS = 0; // Pg. 409 in F.R.M.

    // ADCHS: ADC Input Channel Select Register 
    // Pg. 409 in F.R.M.
    // CH0 positive input is AN7, temperatureBasePlate.
    ADCHSbits.CH0SA = 7;
    	
	// CH1 positive input is AN0, CH2 positive input is AN1, CH3 positive input is AN2.
	ADCHSbits.CH123SA = 0;

	// CH0 negative input is Vref-.
	ADCHSbits.CH0NA = 0;

	// CH1, CH2, CH3 negative inputs are Vref-, which is AVss, which is Vss.  haha.
    ADCHSbits.CH123NA = 0;

    // ADCSSL: ADC Input Scan Select Register 
    ADCSSL = 0; // Pg. 410 F.R.M.
				// I think it sets the order that the A/D inputs are done.  But I'm doing 4 all at the same time, so set it to 0?


    // Turn on A/D module
    ADCON1bits.ADON = 1; // Pg. 416 in F.R.M.  Under "Enabling the Module"
						 // ** It's important to set all the bits above before turning on the A/D module. **
						 // Now the A/D conversions start happening once ADON == 1.
	_ADIP = 4;			 // A/D interrupt priority set to 4.  Default is 4.
	IEC0bits.ADIE = 1;	 // Enable interrupts to happen when a A/D conversion is complete. Pg. 148 of F.R.M.  	

	PDC1 = 0;
	PDC2 = 0;
	PDC3 = 0;
}

void InitQEI() {
	// QEICON starts as all zeros.
	// The Quadrature Encoder Interface.  This is for enabling the encoder.
	switch (savedValues.motorType) {
		case AC_INDUCTION_MOTOR:
			QEICONbits.QEIM = 0b111; 	// enable QEI x4 mode with position counter reset by MAXCNT.  
			QEICONbits.PCDOUT = 1; 	 	// Position Counter Direction Status Output Enable (QEI logic controls state of I/O pin)
			QEICONbits.POSRES = 0;		// Position counter is not reset by index pulse. But there's no index pulse in my case.  haha. This is ignored in this situation.
			QEICONbits.SWPAB = 1;		// don't swap QEA and QEB inputs.
		
			DFLTCONbits.CEID = 1; 		// Interrupts due to position count errors disabled
			DFLTCONbits.QEOUT = 1; 		// Digital filter outputs enabled.  QEA, QEB. 0 means normal pin operation.
			DFLTCONbits.QECK = 0b011; 	// clock prescaler of 16. So, QEA or QEB must be high or low for a time of 16*3 Tcy's. 
										// Fcy = 30MHz.  3*16Tcy is the minimum pulse width required for QEA or QEB to change from high to low or low to high.
										// You can do at most 30,000,000/(3*16) = 625,000 of those pulses per second.  So, you can have at most
										// 625,000 * 4 clock counts per second, since resolution has been multiplied by 4 (QEA and QEB up and down transitions all cause a pulse to be seen by the microcontroller..)  
										//  That means the maximum detectable RPM is:
										// x rev/sec * 2096 clockCounts/Rev = 625,000 * 4 clockCounts/sec.  ASSUMING A 512 tick per revolution encoder like I"m using...
										// So, x = 1220 rev/sec.
										// 
			DFLTCONbits.IMV = 0b01;  	// INDEX pulse happens when QEA is high.  Irrelevant.  I'm not using the index pulse for the AC induction motor.
			MAXCNT = 0xFFFF; 	// reset the counter each time it reaches maxcnt.  It will reset anyway won't it?  I mean, after 0xFFFF is 0x0000!  haha.
								// Use this for the AC controller.  It's easier to measure speed of rotor with this setting, if there's no INDEX signal on the encoder.
			POSCNT = 0;  // How many ticks have gone by so far?  Starts out as zero anyway.  It's safe to write to it though.
		break;
		case NISSAN_LEAF_MOTOR:
			QEICONbits.QEIM = 0b100; 	// enable QEI x2 mode with position counter reset by INDEX pulse. This works out nicely, so that you get 512 ticks per index pulse, so it matches with the normalized 512 electrical degrees. 
			QEICONbits.PCDOUT = 1; 	 	// Position Counter Direction Status Output Enable (QEI logic controls state of I/O pin)
			QEICONbits.POSRES = 1;		// Position counter is reset by index pulse.	
			QEICONbits.SWPAB = 0;		// don't swap QEA and QEB inputs.  
	
			DFLTCONbits.CEID = 1; 		// Interrupts due to position count errors disabled
			DFLTCONbits.QEOUT = 1; 		// Digital filter outputs enabled.  QEA, QEB. 0 means normal pin operation.
			DFLTCONbits.QECK = 0b011; 	// clock prescaler of 16. So, QEA or QEB must be high or low for a time of 16*3 Tcy's. 
										// Fcy = 30MHz.  3*16Tcy is the minimum pulse width required for QEA or QEB to change from high to low or low to high.
										// You can do at most 30,000,000/(3*16) = ??? of those pulses per second.  So, you can have at most
										// ??? * 2 clock counts per second, since resolution has been multiplied by 2 (QEA and QEB up and down transitions all cause a pulse to be seen by the microcontroller..)  
										// 
			DFLTCONbits.IMV = 0b01;  	// INDEX pulse MUST happen when QEA is HIGH. It didn't work for QEA being low with the Leaf motor.
			MAXCNT = 511; 		// If going backwards, poscnt will go from 0 to maxcnt, ONLY IF it is caused by an index pulse!!!
								// Use this for the AC controller.  It's easier to measure speed of rotor with this setting, if there's no INDEX signal on the encoder.
			POSCNT = 15000;  	// It starts in an unknown state before the index pulse happens. Do this so I can know the index pulse hasn't happened yet.  It will vary from 14000 up to 16000 or whatever, and suddenly be forever trapped in 0,511 once the index pulse happens.
			myFirstEncoderIndexPulseTest.startTime = 0;
			myFirstEncoderIndexPulseTest.currentAngleOffset = 0;
			myFirstEncoderIndexPulseTest.testRunning = 1;
		break;
		case TOYOTA_MGR_MOTOR:
			QEICONbits.QEIM = 0b110; 	// enable QEI x4 mode with position counter reset by INDEX pulse. There are 2 electrical revolutions per index pulse with that motor type.  This works out nicely, so that you get 1024 ticks per 2 electrical revolutions per 1024 ticks, so 512 ticks per electrical revolution.
			QEICONbits.PCDOUT = 1; 	 	// Position Counter Direction Status Output Enable (QEI logic controls state of I/O pin)
			QEICONbits.POSRES = 1;		// Position counter is reset by index pulse.	
			QEICONbits.SWPAB = 0;		// don't swap QEA and QEB inputs.  
	
			DFLTCONbits.CEID = 1; 		// Interrupts due to position count errors disabled
			DFLTCONbits.QEOUT = 1; 		// Digital filter outputs enabled.  QEA, QEB. 0 means normal pin operation.
			DFLTCONbits.QECK = 0b011; 	// clock prescaler of 16. So, QEA or QEB must be high or low for a time of 16*3 Tcy's. 
										// Fcy = 30MHz.  3*16Tcy is the minimum pulse width required for QEA or QEB to change from high to low or low to high.
										// You can do at most 30,000,000/(3*16) = ??? of those pulses per second.  So, you can have at most
										// ??? * 2 clock counts per second, since resolution has been multiplied by 2 (QEA and QEB up and down transitions all cause a pulse to be seen by the microcontroller..)  
										// 
			DFLTCONbits.IMV = 0b01;  	// INDEX pulse MUST happen when QEA is HIGH and QEB is LOW. It didn't work for other combinations.
			MAXCNT = 1023; 		// If going backwards, poscnt will go from 0 to maxcnt, ONLY IF it is caused by an index pulse!!!
								// Use this for the AC controller.  It's easier to measure speed of rotor with this setting, if there's no INDEX signal on the encoder.
			POSCNT = 15000;  	// It starts in an unknown state before the index pulse happens. Do this so I can know the index pulse hasn't happened yet.  It will vary from 14000 up to 16000 or whatever, and suddenly be forever trapped in 0,511 once the index pulse happens.
			myFirstEncoderIndexPulseTest.startTime = 0;
			myFirstEncoderIndexPulseTest.currentAngleOffset = 0;
			myFirstEncoderIndexPulseTest.testRunning = 1;
		break;
		case PERMANENT_MAGNET_MOTOR_WITH_ENCODER:
			QEICONbits.QEIM = 0b110; 	// enable QEI x4 mode with position counter reset by INDEX pulse. 
			QEICONbits.PCDOUT = 1; 	 	// Position Counter Direction Status Output Enable (QEI logic controls state of I/O pin)
			QEICONbits.POSRES = 1;		// Position counter is reset by index pulse.	
			QEICONbits.SWPAB = 0;		// don't swap QEA and QEB inputs.  
	
			DFLTCONbits.CEID = 1; 		// Interrupts due to position count errors disabled
			DFLTCONbits.QEOUT = 1; 		// Digital filter outputs enabled.  QEA, QEB. 0 means normal pin operation.
			DFLTCONbits.QECK = 0b011; 	// clock prescaler of 16. So, QEA or QEB must be high or low for a time of 16*3 Tcy's. 
										// Fcy = 30MHz.  3*16Tcy is the minimum pulse width required for QEA or QEB to change from high to low or low to high.
										// You can do at most 30,000,000/(3*16) = ??? of those pulses per second.  So, you can have at most
										// ??? * 2 clock counts per second, since resolution has been multiplied by 2 (QEA and QEB up and down transitions all cause a pulse to be seen by the microcontroller..)  
										// 
			DFLTCONbits.IMV = 0b00;  	// INDEX pulse MUST happen when QEA & QEB is low. It didn't work for QEA being low with the Leaf motor.
			MAXCNT = (savedValues2.encoderTicks << 2) - 1; 		// If going backwards, poscnt will go from 0 to maxcnt, ONLY IF it is caused by an index pulse!!!  Multiply by 4 since I"m doing 4* the resolution.
								// Use this for the AC controller.  It's easier to measure speed of rotor with this setting, if there's no INDEX signal on the encoder.
			POSCNT = 15000;  	// It starts in an unknown state before the index pulse happens. Do this so I can know the index pulse hasn't happened yet.  It will vary from 14000 up to 16000 or whatever, and suddenly be forever trapped in [0,MAX_CNT] once the index pulse happens.
			myFirstEncoderIndexPulseTest.startTime = 0;
			myFirstEncoderIndexPulseTest.currentAngleOffset = 0;
			myFirstEncoderIndexPulseTest.testRunning = 1;
//			encoderTicksDivPolePairs = __builtin_divsd((long int)savedValues2.encoderTicks,(int)savedValues2.numberOfPolePairs);
		break;
	}
}

void EESaveValues() {  // save the new stuff.
	static volatile int i = 0;
	EEDataInRam1[0] = savedValues.motorType;
	EEDataInRam1[1] = savedValues.Kp;						// proportional gain shared between Id and Iq.
	EEDataInRam1[2] = savedValues.Ki;						// integreal gain shared between Id and Iq.
	EEDataInRam1[3] = savedValues.currentSensorAmpsPerVolt;	// Ex:  if a 
	EEDataInRam1[4] = savedValues.maxRegenPosition;			// 
	EEDataInRam1[5] = savedValues.minRegenPosition;			// 
	EEDataInRam1[6] = savedValues.minThrottlePosition;		//	
	EEDataInRam1[7] = savedValues.maxThrottlePosition;		// 
	EEDataInRam1[8] = savedValues.throttleFaultPosition;	// 
	EEDataInRam1[9] = savedValues.maxBatteryAmps;			//
	EEDataInRam1[10] = savedValues.maxBatteryAmpsRegen;		// 
	EEDataInRam1[11] = savedValues.maxMotorAmps;			//
	EEDataInRam1[12] = savedValues.maxMotorAmpsRegen;		// 
	EEDataInRam1[13] = savedValues.prechargeTime;			// 
	EEDataInRam1[14] = 0;
	EEDataInRam1[15] = 0;									// crc computed later.

	EEDataInRam2[0] = savedValues2.angleOffset;
	EEDataInRam2[1] = savedValues2.rotorTimeConstantIndex;
	EEDataInRam2[2] = savedValues2.numberOfPolePairs;
	EEDataInRam2[3] = savedValues2.maxRPM;
	EEDataInRam2[4] = savedValues2.throttleType;
	EEDataInRam2[5] = savedValues2.encoderTicks;
	EEDataInRam2[6] = savedValues2.dataToDisplaySet1;
	EEDataInRam2[7] = savedValues2.dataToDisplaySet2;
	EEDataInRam2[8] = savedValues2.KArrayIndex;
	EEDataInRam2[9] = 0;	// spares[0]
	EEDataInRam2[10] = 0;	// spares[1]
	EEDataInRam2[11] = 0;	// spares[2]
	EEDataInRam2[12] = 0;	// spares[3]
	EEDataInRam2[13] = 0;	// spares[4]
	EEDataInRam2[14] = 0;	// spares[5]
	EEDataInRam2[15] = 0;	// crc

	for (i = 0; i < 15; i++) {
		EEDataInRam1[15] += EEDataInRam1[i];	// compute checksum.
		EEDataInRam2[15] += EEDataInRam2[i];
	}

    _erase_eedata(EE_addr1, _EE_ROW);  // 
    _wait_eedata();  // #define _wait_eedata() { while (NVMCONbits.WR); }
	ClrWdt();
    _erase_eedata(EE_addr2, _EE_ROW);  // 
    _wait_eedata();  // #define _wait_eedata() { while (NVMCONbits.WR); }
	ClrWdt();
    _erase_eedata(EE_addr3, _EE_ROW);  // 
    _wait_eedata();  // #define _wait_eedata() { while (NVMCONbits.WR); }
	ClrWdt();
    _erase_eedata(EE_addr4, _EE_ROW);  // 
    _wait_eedata();  // #define _wait_eedata() { while (NVMCONbits.WR); }
	ClrWdt();
    // Write a row to EEPROM from array "EEDataInRam1"
    _write_eedata_row(EE_addr1, EEDataInRam1); // first copy of savedValues.
    _wait_eedata();  // 
	ClrWdt();
    // Write a row to EEPROM from array "EEDataInRam1".  
    _write_eedata_row(EE_addr2, EEDataInRam1); // 2nd copy of savedValues.
    _wait_eedata();  // 
	ClrWdt();
    // Write a row to EEPROM from array "EEDataInRam2"
    _write_eedata_row(EE_addr3, EEDataInRam2); // 1st copy of savedValues2.
    _wait_eedata();  // 
	ClrWdt();
    // Write a row to EEPROM from array "EEDataInRam2"
    _write_eedata_row(EE_addr4, EEDataInRam2); // 2nd copy of savedValues2.
    _wait_eedata();  // 
	ClrWdt();
	// 2 copies of the same thing, to be more robust.
}

void MoveDataFromEEPromToRAM() {
	static volatile int i = 0;
	static volatile unsigned int CRC1 = 0, CRC2 = 0, CRC3 = 0, CRC4 = 0;

	_memcpy_p2d16(EEDataInRam1, EE_addr1, _EE_ROW);
	_memcpy_p2d16(EEDataInRam2, EE_addr2, _EE_ROW);
	_memcpy_p2d16(EEDataInRam3, EE_addr3, _EE_ROW);
	_memcpy_p2d16(EEDataInRam4, EE_addr4, _EE_ROW);
	for (i = 0; i < 15; i++) { // Skip the last one, which is CRC. So, just go from 0 up to 14.
		CRC1 += EEDataInRam1[i];
		CRC2 += EEDataInRam2[i];
		CRC3 += EEDataInRam3[i];
		CRC4 += EEDataInRam4[i];		
	}

	if (EEDataInRam1[15] == CRC1) {  // crc from EEProm is OK for copy 1.  There has been a previously saved configuration.  
		savedValues.motorType = EEDataInRam1[0];
		savedValues.Kp = EEDataInRam1[1];		// 
		savedValues.Ki = EEDataInRam1[2];						// 
		savedValues.currentSensorAmpsPerVolt = EEDataInRam1[3];		// 
		savedValues.maxRegenPosition = EEDataInRam1[4];		// 
		savedValues.minRegenPosition = EEDataInRam1[5];		// 
		savedValues.minThrottlePosition = EEDataInRam1[6];	// 
		savedValues.maxThrottlePosition = EEDataInRam1[7];	// 
		savedValues.throttleFaultPosition = EEDataInRam1[8];	// 
		savedValues.maxBatteryAmps = EEDataInRam1[9];		// 
		savedValues.maxBatteryAmpsRegen = EEDataInRam1[10];	// 
		savedValues.maxMotorAmps = EEDataInRam1[11];		// 
		savedValues.maxMotorAmpsRegen = EEDataInRam1[12];	//  
		savedValues.prechargeTime = EEDataInRam1[13];		//
		savedValues.spares[0] = EEDataInRam1[14];			//
		savedValues.crc = EEDataInRam1[15];					// 
	}
	else if (EEDataInRam2[15] == CRC2) {  // crc from EEProm is OK for copy 1.  There has been a previously saved configuration.  
		savedValues.motorType = EEDataInRam2[0];
		savedValues.Kp = EEDataInRam2[1];		// 
		savedValues.Ki = EEDataInRam2[2];						// 
		savedValues.currentSensorAmpsPerVolt = EEDataInRam2[3];		// 
		savedValues.maxRegenPosition = EEDataInRam2[4];		// 
		savedValues.minRegenPosition = EEDataInRam2[5];		// 
		savedValues.minThrottlePosition = EEDataInRam2[6];	// 
		savedValues.maxThrottlePosition = EEDataInRam2[7];	// 
		savedValues.throttleFaultPosition = EEDataInRam2[8];	// 
		savedValues.maxBatteryAmps = EEDataInRam2[9];		// 
		savedValues.maxBatteryAmpsRegen = EEDataInRam2[10];	// 
		savedValues.maxMotorAmps = EEDataInRam2[11];		// 
		savedValues.maxMotorAmpsRegen = EEDataInRam2[12];	//  
		savedValues.prechargeTime = EEDataInRam2[13];		//
		savedValues.spares[0] = EEDataInRam2[14];			//
		savedValues.crc = EEDataInRam2[15];					// 
	}
	else {
		savedValues = savedValuesDefault;
		savedValues.crc = 	savedValues.motorType + 
							savedValues.Kp + 
							savedValues.Ki + 
							savedValues.currentSensorAmpsPerVolt + 
							savedValues.maxRegenPosition + 
							savedValues.minRegenPosition + 
							savedValues.minThrottlePosition + 
							savedValues.maxThrottlePosition + 
							savedValues.throttleFaultPosition + 
							savedValues.maxBatteryAmps + 
							savedValues.maxBatteryAmpsRegen + 
							savedValues.maxMotorAmps + 
							savedValues.maxMotorAmpsRegen + 
							savedValues.prechargeTime + 
							savedValues.spares[0];
	}
	if (EEDataInRam3[15] == CRC3) {
		savedValues2.angleOffset = EEDataInRam3[0];
		myAngleOffsetTest.currentAngleOffset = savedValues2.angleOffset;	// this is the working copy
		savedValues2.rotorTimeConstantIndex = EEDataInRam3[1];		// 
		myRotorTest.timeConstantIndex = savedValues2.rotorTimeConstantIndex;	// this is the working copy
		savedValues2.numberOfPolePairs = EEDataInRam3[2];						// 
		savedValues2.maxRPM = EEDataInRam3[3];		// 
		savedValues2.throttleType = EEDataInRam3[4];
		savedValues2.encoderTicks = EEDataInRam3[5];
		savedValues2.dataToDisplaySet1 = EEDataInRam3[6];
		savedValues2.dataToDisplaySet2 = EEDataInRam3[7];
		savedValues2.KArrayIndex = EEDataInRam3[8];
		myMotorSaliencyTest.KArrayIndex = savedValues2.KArrayIndex;	// this is the working copy

		savedValues2.spares[0] = EEDataInRam3[9];
		savedValues2.spares[1] = EEDataInRam3[10];
		savedValues2.spares[2] = EEDataInRam3[11];
		savedValues2.spares[3] = EEDataInRam3[12];
		savedValues2.spares[4] = EEDataInRam3[13];
		savedValues2.spares[5] = EEDataInRam3[14];
		savedValues2.crc = EEDataInRam3[15];					// 
	}
	else if (EEDataInRam4[15] == CRC4) {
		savedValues2.angleOffset = EEDataInRam4[0];
		myAngleOffsetTest.currentAngleOffset = savedValues2.angleOffset;	// this is the working copy
		savedValues2.rotorTimeConstantIndex = EEDataInRam4[1];		// 
		myRotorTest.timeConstantIndex = savedValues2.rotorTimeConstantIndex;	// this is the working copy
		savedValues2.numberOfPolePairs = EEDataInRam4[2];						// 
		savedValues2.maxRPM = EEDataInRam4[3];		// 
		savedValues2.throttleType = EEDataInRam4[4];
		savedValues2.encoderTicks = EEDataInRam4[5];
		savedValues2.dataToDisplaySet1 = EEDataInRam4[6];
		savedValues2.dataToDisplaySet2 = EEDataInRam4[7];
		savedValues2.KArrayIndex = EEDataInRam3[8];
		myMotorSaliencyTest.KArrayIndex = savedValues2.KArrayIndex;	// this is the working copy

		savedValues2.spares[0] = EEDataInRam4[9];
		savedValues2.spares[1] = EEDataInRam4[10];
		savedValues2.spares[2] = EEDataInRam4[11];
		savedValues2.spares[3] = EEDataInRam4[12];
		savedValues2.spares[4] = EEDataInRam4[13];
		savedValues2.spares[5] = EEDataInRam4[14];
		savedValues2.crc = EEDataInRam4[15];					// 
	}
	else {	// There wasn't a single good copy.  Load the default configuration.
		savedValues2 = savedValuesDefault2;
		myAngleOffsetTest.currentAngleOffset = savedValues2.angleOffset;	// this is the working copy
		myRotorTest.timeConstantIndex = savedValues2.rotorTimeConstantIndex;	// this is the working copy
		myMotorSaliencyTest.KArrayIndex = savedValues2.KArrayIndex;	// this is the working copy

		savedValues2.crc =  savedValues2.angleOffset + 
							savedValues2.rotorTimeConstantIndex + 
							savedValues2.numberOfPolePairs + 
							savedValues2.maxRPM + 
							savedValues2.throttleType +
							savedValues2.encoderTicks +
							savedValues2.dataToDisplaySet1 + 
							savedValues2.dataToDisplaySet2 +
							savedValues2.KArrayIndex +
							savedValues2.spares[0] + 
							savedValues2.spares[1] +
							savedValues2.spares[2] + 
							savedValues2.spares[3] +
							savedValues2.spares[4] + 
							savedValues2.spares[5];
	}
}

void InitializeThrottleAndCurrentVariables() {
	// run this at startup, when there's a new savedValues.currentSensorAmpsPerVolt
	// Ex:  MaxMotorAmps = 300
	// 		currentSensorAmpsPerVolt = 480, which is for a LEM Hass 300-s
	// 		ticksPerAmp_times128 = 26214/480 = 54.6 = 54
	//		totalADTicks_times128 = 54 * maxMotorAmps = 54 * 300 = 16200
	//		maxMotorCurrentNormalized = 16200 >> 3 = 2025
	//
	//
	//
	//
	//
	// Ex:  MaxMotorAmps = 8
	// 		currentSensorAmpsPerVolt = 16, which is for a lem hass 50-s with 
	//		ticksPerAmp_times128 = 27214/16 = 1700.8 = 1700
	// 		totalADTicks_times128 = 1700 * maxMotorAmps = 1700 * 8 = 13600
	//		maxMotorCurrentNormalized = 1700
	//
	//
	//
	//
	//
	static volatile int ADTicksPerAmp_times128 = 0;
	static volatile long totalADTicks_times128 = 0;

	//ADTicksPerAmp_times128 = 128 * (1024/5) / currentSensorAmpsPerVolt; // 1024 A/D ticks per 5v.
	//ADTicksPerAmp_times128 = 26214 / currentSensorAmpsPerVolt;
	ADTicksPerAmp_times128 = (int)__builtin_divsd(26214L,(int)savedValues.currentSensorAmpsPerVolt);
//	ampToNormalizedMultiplier = ADTicksPerAmp_times128 >> 5;
	//totalADTicks_times128 = (ADTicksPerAmp_times128 * savedValues.maxMotorRegenAmps);
	totalADTicks_times128 = __builtin_mulss((int)ADTicksPerAmp_times128, (int)savedValues.maxMotorAmpsRegen);
	if ((totalADTicks_times128 >> 3) > 4096) {
		maxMotorCurrentNormalizedRegen = 4096;
	}
	else {
		maxMotorCurrentNormalizedRegen = totalADTicks_times128 >> 3;  // to go from [-256*128, 256*128] to [-4096, 4096], divide by 8.  I'm assuming a MAX current sensor acceptable range from [1.25v, 3.75v].
	}

	//totalADTicksRegen_times128 = (ADTicksPerAmp_times128 * savedValues.maxMotorRegenAmps);
	totalADTicks_times128 = __builtin_mulss((int)ADTicksPerAmp_times128, (int)savedValues.maxMotorAmps);
	if ((totalADTicks_times128 >> 3) > 4096) {
		maxMotorCurrentNormalized = 4096;
	}
	else {
		maxMotorCurrentNormalized = totalADTicks_times128 >> 3;  // to go from [-256*128, 256*128] to [-4096, 4096], divide by 8.  I'm assuming a current sensor acceptable range from [1.25v, 3.75v].
	}

	totalADTicks_times128 = __builtin_mulss((int)ADTicksPerAmp_times128, (int)savedValues.maxBatteryAmps);	; // go from amps to normalized.  Normalized is following the above process.
	if ((totalADTicks_times128 >> 3) > 4096) {
		maxBatteryCurrentNormalized = 4096;
	}
	else {
		maxBatteryCurrentNormalized = totalADTicks_times128 >> 3;  // to go from [-256*128, 256*128] to [-4096, 4096], divide by 8.  I'm assuming a current sensor acceptable range from [1.25v, 3.75v].
	}

	totalADTicks_times128 = __builtin_mulss((int)ADTicksPerAmp_times128, (int)savedValues.maxBatteryAmpsRegen);	; // go from amps to normalized.  Normalized is following the above process.
	if ((totalADTicks_times128 >> 3) > 4096) {
		maxBatteryCurrentNormalizedRegen = 4096;
	}
	else {
		maxBatteryCurrentNormalizedRegen = totalADTicks_times128 >> 3;  // to go from [-256*128, 256*128] to [-4096, 4096], divide by 8.  I'm assuming a current sensor acceptable range from [1.25v, 3.75v].
	}
	currentSensorAmpsPerVoltTimes5 = (int)__builtin_mulss((int)savedValues.currentSensorAmpsPerVolt, 5);  // when converting from the normalized [0, 4096] to real life amps, the conversion factor is currentSensorAmpsPerVolt*5/16384.
}

void GrabDataSnapshot() {
	static volatile int delta = 0;
	static volatile int offset = 0;
	static volatile int i = 0;

	myDataStream.Id_times10 = Id;
	myDataStream.Iq_times10 = Iq;
	myDataStream.IdRef_times10 = IdRef;
	myDataStream.IqRef_times10 = IqRef;
	myDataStream.Vd = Vd;
	myDataStream.Vq = Vq;
	myDataStream.Ia_times10 = Ia;
	myDataStream.Ib_times10 = Ib;
	myDataStream.Ic_times10 = Ic;
	myDataStream.Va = Va;
	myDataStream.Vb = Vb;
	myDataStream.Vc = Vc;
	myDataStream.rawThrottle = rawThrottle;
	myDataStream.throttle = throttle;
	myDataStream.temperature = temperatureBasePlate;
	myDataStream.slipSpeedRPM = slipSpeedRPS_times16;
	myDataStream.electricalSpeedRPM = rotorFluxRPS_times16; // revolutions per 16 seconds for the rotor flux.
	myDataStream.mechanicalSpeedRPM = RPS_times16; // REVOLUTIONS PER 16 SECONDS.
	myDataStream.batteryAmps_times10 = batteryCurrentNormalized; // in the range of [-4096, 4096], where 4096 corresponds to 3.75v on the AD feedback, and -4096 corresponds to 1.25v.  Later convert that to amps.


	myDataStream.slipSpeedRPM = __builtin_mulss(15,myDataStream.slipSpeedRPM) >> 2;
	myDataStream.mechanicalSpeedRPM = __builtin_mulss(15,myDataStream.mechanicalSpeedRPM) >> 2;
	myDataStream.electricalSpeedRPM = __builtin_mulss(15,myDataStream.electricalSpeedRPM) >> 2;
	myDataStream.batteryAmps_times10 = __builtin_mulss(myDataStream.batteryAmps_times10*5, currentSensorAmpsPerVoltTimes5) >> 13;  // [-4096, 4096] -> [-amps*10, amps*10].  To go from 4096 to amps*10, do 10 * x ticks * currentSensorAmpsPerVolt * 1.25 volts / 4096 ticks.
	myDataStream.Ia_times10 = __builtin_mulss(myDataStream.Ia_times10*5, currentSensorAmpsPerVoltTimes5) >> 13;  // [-4096, 4096] -> [-amps*10, amps*10].  To go from 4096 to amps*10, do 10 * x ticks * currentSensorAmpsPerVolt * 1.25 volts / 4096 ticks.
	myDataStream.Ib_times10 = __builtin_mulss(myDataStream.Ib_times10*5, currentSensorAmpsPerVoltTimes5) >> 13;  // [-4096, 4096] -> [-amps*10, amps*10].  To go from 4096 to amps*10, do 10 * x ticks * currentSensorAmpsPerVolt * 1.25 volts / 4096 ticks.
	myDataStream.Ic_times10 = __builtin_mulss(myDataStream.Ic_times10*5, currentSensorAmpsPerVoltTimes5) >> 13;  // [-4096, 4096] -> [-amps*10, amps*10].  To go from 4096 to amps*10, do 10 * x ticks * currentSensorAmpsPerVolt * 1.25 volts / 4096 ticks.
	myDataStream.IdRef_times10 = __builtin_mulss(myDataStream.IdRef_times10*5, currentSensorAmpsPerVoltTimes5) >> 13;  // [-4096, 4096] -> [-amps*10, amps*10].  To go from 4096 to amps*10, do 10 * x ticks * currentSensorAmpsPerVolt * 1.25 volts / 4096 ticks.
	myDataStream.IqRef_times10 = __builtin_mulss(myDataStream.IqRef_times10*5, currentSensorAmpsPerVoltTimes5) >> 13;  // [-4096, 4096] -> [-amps*10, amps*10].  To go from 4096 to amps*10, do 10 * x ticks * currentSensorAmpsPerVolt * 1.25 volts / 4096 ticks.
	myDataStream.Id_times10 = __builtin_mulss(myDataStream.Id_times10*5, currentSensorAmpsPerVoltTimes5) >> 13;  // [-4096, 4096] -> [-amps*10, amps*10].  To go from 4096 to amps*10, do 10 * x ticks * currentSensorAmpsPerVolt * 1.25 volts / 4096 ticks.
	myDataStream.Iq_times10 = __builtin_mulss(myDataStream.Iq_times10*5, currentSensorAmpsPerVoltTimes5) >> 13;  // [-4096, 4096] -> [-amps*10, amps*10].  To go from 4096 to amps*10, do 10 * x ticks * currentSensorAmpsPerVolt * 1.25 volts / 4096 ticks.
// How to convert from Va to real volts?  I think just divide by 1690 and multiply by batterypackvoltage?  1690 is the max radius.
//	myDataStream.Vd = __builtin_divsd(__builtin_mulss(myDataStream.Vd, savedValues2.packVoltage), R_MAX);
//	myDataStream.Vq = __builtin_divsd(__builtin_mulss(myDataStream.Vq, savedValues2.packVoltage), R_MAX);
//	myDataStream.Va = __builtin_divsd(__builtin_mulss(myDataStream.Va, savedValues2.packVoltage), R_MAX);
//	myDataStream.Vb = __builtin_divsd(__builtin_mulss(myDataStream.Vb, savedValues2.packVoltage), R_MAX);
//	myDataStream.Vc = __builtin_divsd(__builtin_mulss(myDataStream.Vc, savedValues2.packVoltage), R_MAX);
	myDataStream.percentOfVoltageDiskBeingUsed = __builtin_divsd(__builtin_mulss(100,rGlobal_filtered), R_MAX);
	myDataStream.temperature = __builtin_divsd(4812800L,myDataStream.temperature) - 5700;  // convert to the variable resisance value. 16077 
	delta = 32;
	offset = 64;
	for (i = 0; i < 6; i++) {
		if (myDataStream.temperature >= celciusToResistance[offset-1]) {
			offset = offset - delta;
		}
		else if (myDataStream.temperature < celciusToResistance[offset-1]) {
			offset = offset + delta;
		}
		delta >>= 1;
	}
	myDataStream.temperature = offset;
	myDataStream.timer = counter1k - myDataStream.startTime;
}

void ComputeZeroCurrentOffsets() {
	int now;
	int localCurrent1, localCurrent2;
	long int vRef1Sum = 0;
	long int vRef2Sum = 0;
	int i = 0;

	for (i = 0; i < 256; i++) {
		now = counter10k;
		while (counter10k == now) {
			ClrWdt();
		} // a new A/D value will be available.
		localCurrent1 = ADCurrent1;
		localCurrent2 = ADCurrent2;
		vRef1Sum += (long)localCurrent1;
		vRef2Sum += (long)localCurrent2;
	}
	vRef1 = (vRef1Sum >> 8);
	vRef2 = (vRef2Sum >> 8);
	if (vRef1 > 512 + 50 || vRef1 < 512 - 50 || vRef2 > 512 + 50 || vRef2 < 512 - 50) {
 		faultBits |= VREF_FAULT;
	}
}

void ChargeUpCapacitorBank() {
	O_LAT_PRECHARGE_RELAY = 1;  // turn on precharge relay.
	DelayTenthsSecond(savedValues.prechargeTime + 1);  // Make sure at least 5 time constants for precharge time!!
	O_LAT_CONTACTOR = 1;  // close main contactor.
	DelayTenthsSecond(2);
	O_LAT_PRECHARGE_RELAY = 0;  // turn on precharge relay.
}

void UpdateCounter1k() {
	if (TMR1 > 115) {
		counter1k++;
		TMR1 = 0;
	}
}

void RunPITest() {
//	myPI.error_d = IdRef - Id;
//	myPI.error_q = IqRef - Iq;
	if ((counter10k - myPI.previousTestCompletionTime) < 2000) {  // wait 0.2 seconds between tests.  That gives Id and Iq a chance to go back to zero.
		IdRef = 0;
		IqRef = 0;
	}
	else {  // I'm running the PI loop test on a particular Kp and Ki to see if it passes the convergence test below.
		IdRef = 0;  // 512 on a scale of 0 to 4096 corresponds to 75 amps for a LEM Hass 300-s.  Because 4096 means 600amps.
		IqRef = 511;
	
		if (myPI.iteration == 0) {
			myPI.iteration++;
		}
		else {  // First, deal with the indicators that things are very very bad, and you need to start over with small Kp and Ki, but a larger maxIterationsBeforeZeroCrossing.
			if (Iq > IqRef + 300) {  // Truly horrible.  Start over.  The PI values are way to big at this point.
				currentMaxIterationsBeforeZeroCrossing += 20;
				InitPIStruct();
				myPI.testRunning = 1;
				return;
			}
			if (Iq < -300) {  // Horrible oscillation.  We have too large of PI values.  Start over with a larger maxIterationsBeforeZeroCrossing.
				currentMaxIterationsBeforeZeroCrossing += 20;
				InitPIStruct();
				myPI.testRunning = 1;
				return;				
			}
			if (myPI.error_q > 300 && myPI.zeroCrossingIndex >= 0) {  // Iq already went above IqRef, but now Iq is way less than IqRef.  It's not converging, it's oscillating BADLY. move on!
				currentMaxIterationsBeforeZeroCrossing += 20;
				InitPIStruct();
				myPI.testRunning = 1;	
				return;				
			}

			if (myPI.error_q < -150) { // -80) {  // If Iq > IqRef + 160.  We don't want overshoot!!
				MoveToNextPIValues();
			}
			else if (Iq < -200) {  //  Iq starts as zero, and should head up to 511.  If it went negative.  That's not good.
				MoveToNextPIValues();
			}
			else if (myPI.zeroCrossingIndex == -1 && myPI.iteration > myPI.maxIterationsBeforeZeroCrossing) {  // myPI.zeroCrossingIndex == -1 means error hasn't crossed zero yet.  It has only been positive.
				MoveToNextPIValues();  // CONVERGENCE TOO SLOW!!!  Move on!
			}
			else if (myPI.error_q > 150 && myPI.zeroCrossingIndex >= 0) {  // Iq already went above IqRef, but now Iq is way less than IqRef.  It's not converging, it's oscillating. move on!
				MoveToNextPIValues();
			}
			else {
				if (myPI.error_q <= 0 && myPI.zeroCrossingIndex == -1) {  // if it's crossing zero for the first time, record the location.
					myPI.zeroCrossingIndex = myPI.iteration;
				}
				myPI.iteration++;
				if (myPI.iteration >= 750) {  // 750 iterations of the PI loop happened, and it passed all the rigorous requirements.  Save Kp & Kq constants.  They are keepers!
					savedValues.Kp = myPI.Kp;
					savedValues.Ki = myPI.Ki;
					myPI.testRunning = 0;  // You found a good PI value, so quit hunting!
					myPI.testFailed = 0;
					myPI.testFinished = 1;
					currentMaxIterationsBeforeZeroCrossing = 20;
					return;
				}
			}
			if (myPI.Kp > 20000 || currentMaxIterationsBeforeZeroCrossing >= 400) {  // True, abject failure.  So sad.
				currentMaxIterationsBeforeZeroCrossing = 20;
				InitPIStruct();
				myPI.testFailed = 1;
				myPI.testFinished = 1;
			}
		}
	}
}

//void RunPITest2() {
//	if ((counter10k - myPI.previousTestCompletionTime) < 1000) {  // wait 0.1 seconds between tests.  That gives Id and Iq a chance to go back to zero.
//		IdRef = 0;
//		IqRef = 0;
//	}
//	else {  // I'm running the PI loop test on a particular Kp and Ki to see if it passes the convergence test below.
//		IdRef = 0;  // 512 on a scale of 0 to 4096 corresponds to 75 amps for a LEM Hass 300-s.  Because 4096 means 600amps.
//		IqRef = 511;
//		bigArray1[myPI.iteration] = myPI.error_d;
//		bigArray2[myPI.iteration] = myPI.error_q;
//		if (myPI.iteration < 254) {
//			myPI.iteration++;
//		}
//		else {
//			InitPIStruct();
//			myPI.testFinished = 1;
//		}
//	}
//}
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
