seedrick/Open-ReVolt-AC/(commit log)

2016-07-27 Hardware documentation
    Added whatever schematics/PCB I had pending verification that they're
    the most recent.
    [ControlAndDriverBoardUpdated.pcb, ControlAndDriverBoardUpdated.sch]
2016-07-27 BOM
    Added preliminary Bill of Materials
    [ControlAndDriverBoardUpdated (Bill Of Materials).csv]
2016-07-27 Updates
    Added ATTiny code and PDF schematic.
2016-07-28 Hardware updates
    Updated .sch file and generated new pdf.
    [ControlAndDriverBoardUpdated.sch]
2016-07-28 File structure
    Changed some file names and made sub-directories for organization's
    sake.
    [ControlAndDriverBoard (Bill Of Materials).csv, ControlAndDriverBoard.pcb, ControlAndDriverBoard.sch]
2016-08-12 Compile error
    Commented out undeclared function with undeclared variables to get rid
    of compile errors.
    [ACController.c]
2016-08-12 Updates
    Flagged schematic/PCB as deprecated in the README. Added latest BOM and
    updated instructions.
    [ACControlAndDriverBoard.xlsx, ControlAndDriverBoard (Bill Of Materials).csv]
2016-08-23 Updates
    -Correct BOM, Schematics, and PCB files.
    -Hex file for ATTiny25 added.
    -Debug code added
    [AC Control BoM.xlsx, ACControlAndDriverBoard.xlsx, ACControlAndDriverBoard1.pcb, ACControlAndDriverBoard1.sch, ControlAndDriverBoard.pcb, ControlAndDriverBoard.sch]
2016-08-23 File Structure
    oops'd some folders
    [~ACControlAndDriverBoard1.sch]
